JheanSilva/img-vent/AFS/STG-AFS500.png

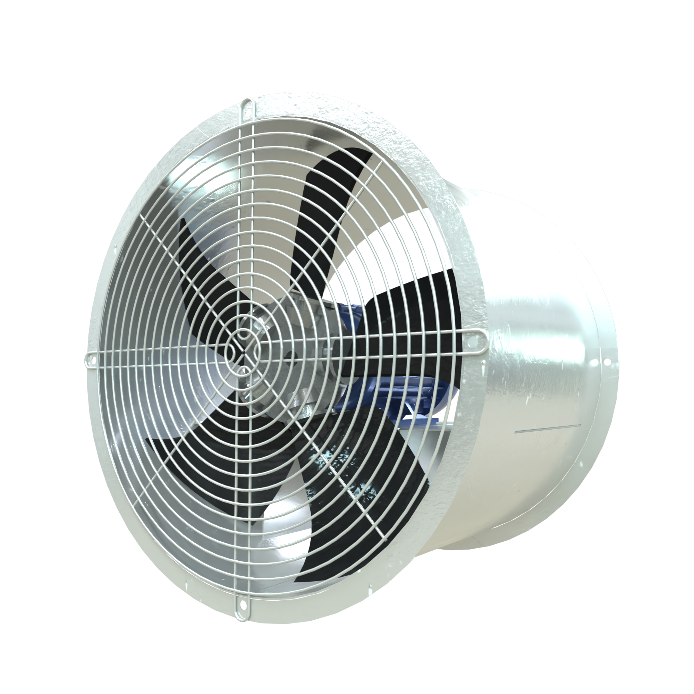
AFS/STG-AFS500.png
