JheanSilva/img-vent/AFS/STG-AFS800.png

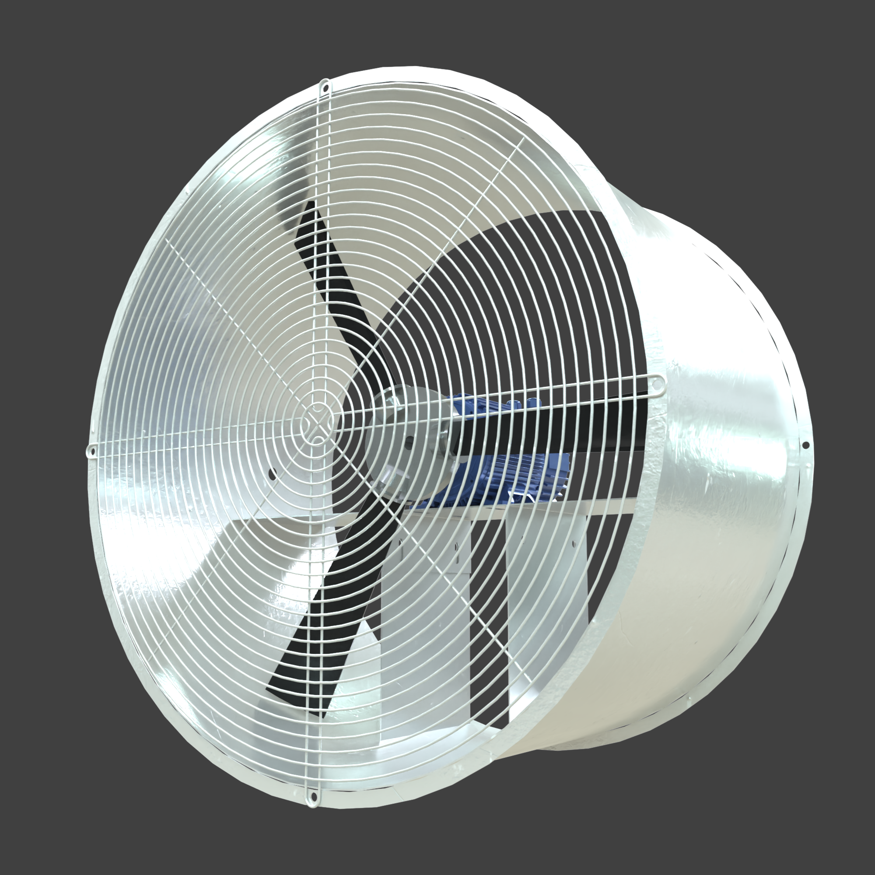
AFS/STG-AFS800.png
