JheanSilva/img-vent/AFSW/AFSW800.png

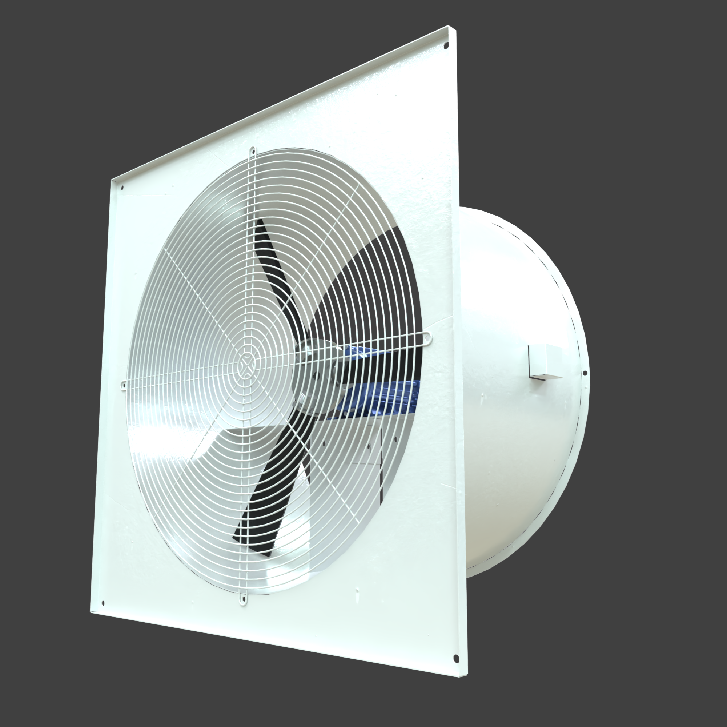
AFSW/AFSW800.png
