JheanSilva/img-vent/AFSW/STG-AFSW500.png

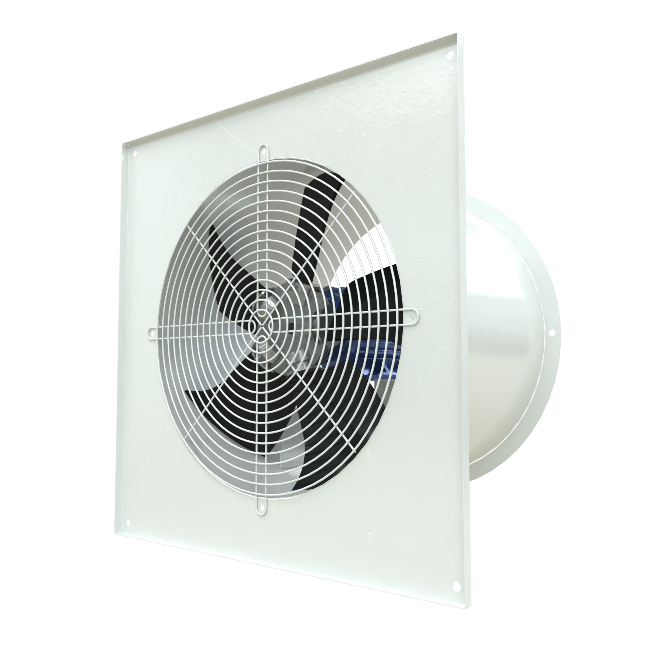
AFSW/STG-AFSW500.png
