JheanSilva/img-vent/AJF/STG-AJF.png

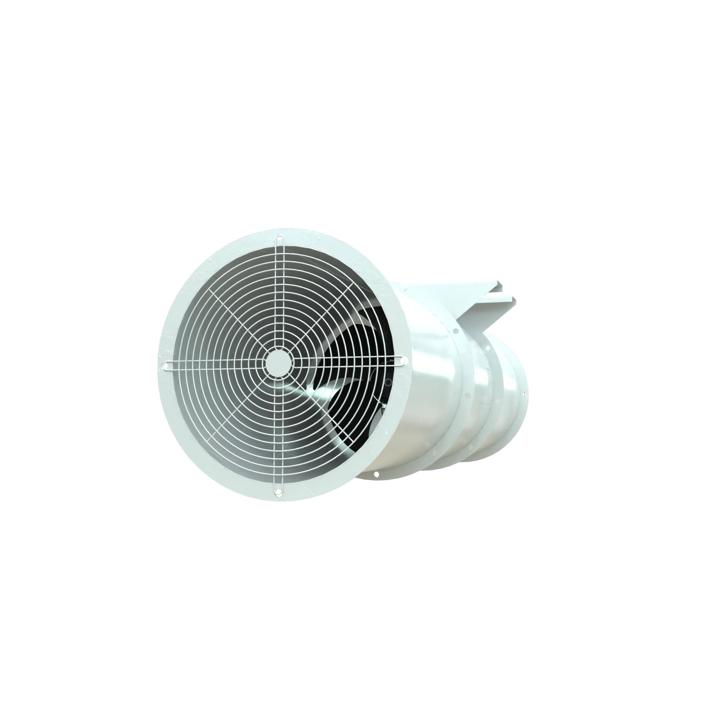
AJF/STG-AJF.png
