JheanSilva/img-vent/PF/STG-PF.png

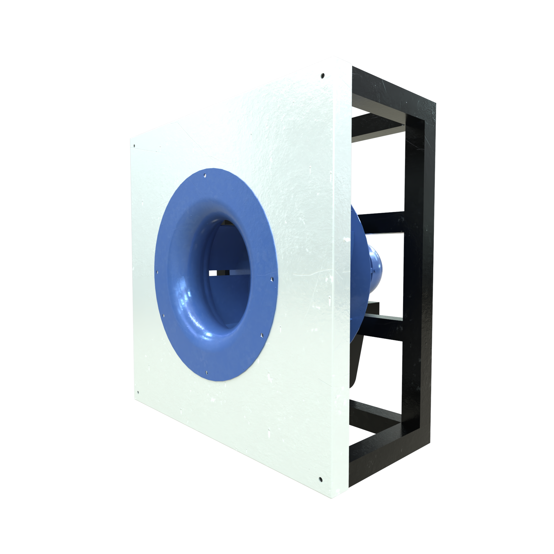
PF/STG-PF.png
