JheanSilva/img-vent/RFV/STG-RFV.png

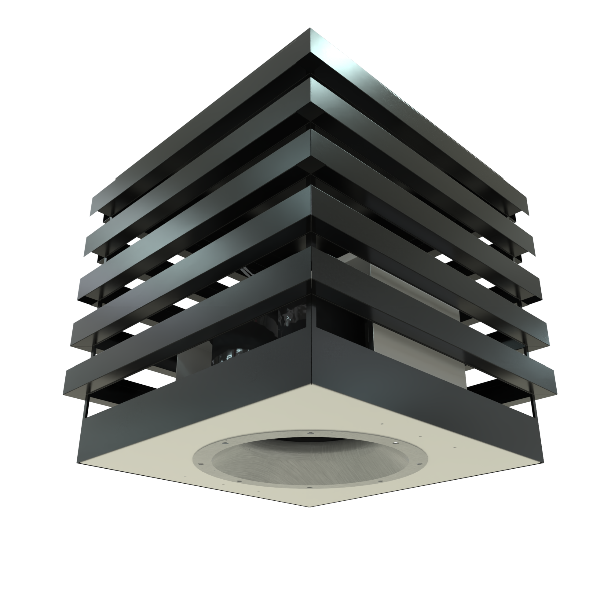
RFV/STG-RFV.png
