JheanSilva/img-vent/SJF/STG-SJF DUPLO.png

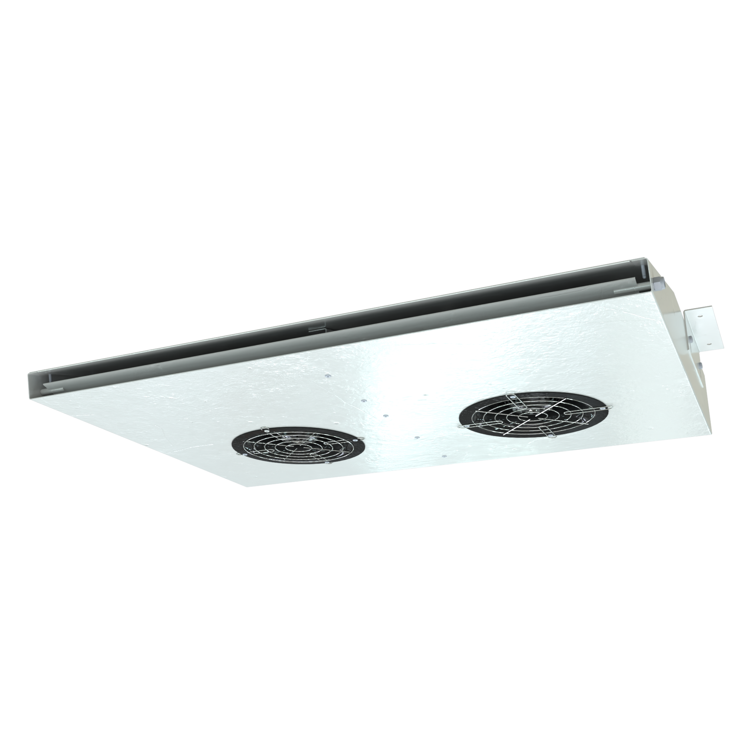
SJF/STG-SJF DUPLO.png
