JheanSilva/img-vent/SJF/STG-SJF.png

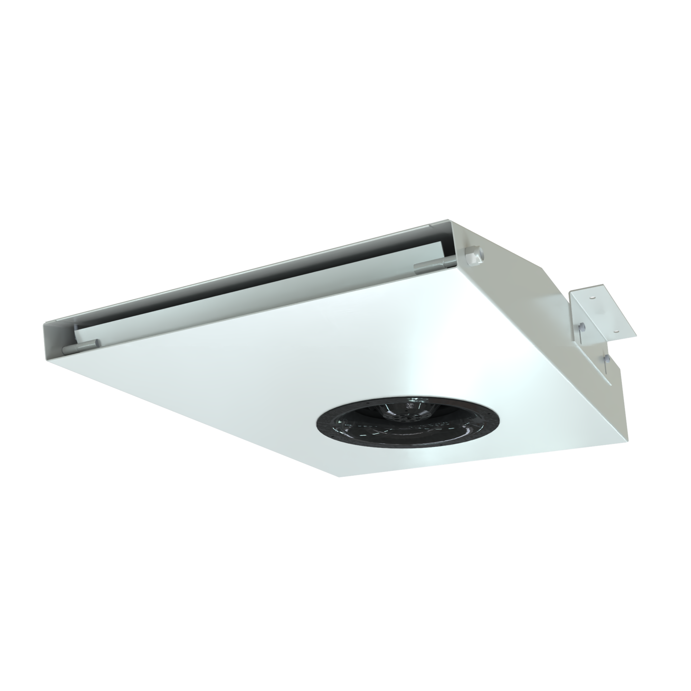
SJF/STG-SJF.png
