JheanSilva/img-vent/VB/STG-VB200.png

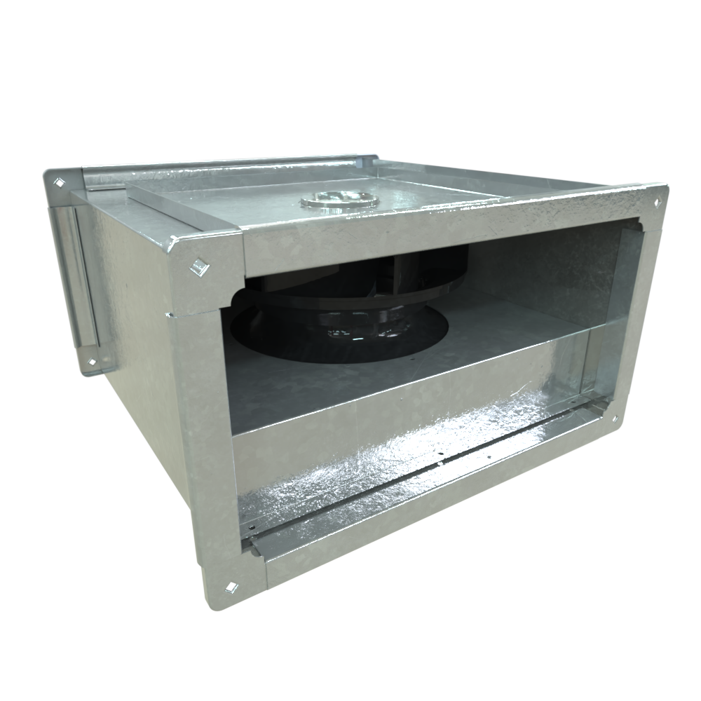
VB/STG-VB200.png
