JheanSilva/img-vent/VB/STG-VB 2.png

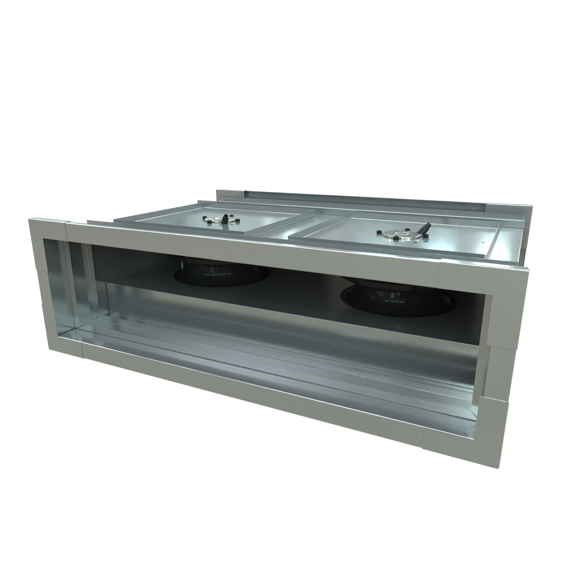
VB/STG-VB 2.png
