JheanSilva/img-vent/VB/STG-VB 4.png

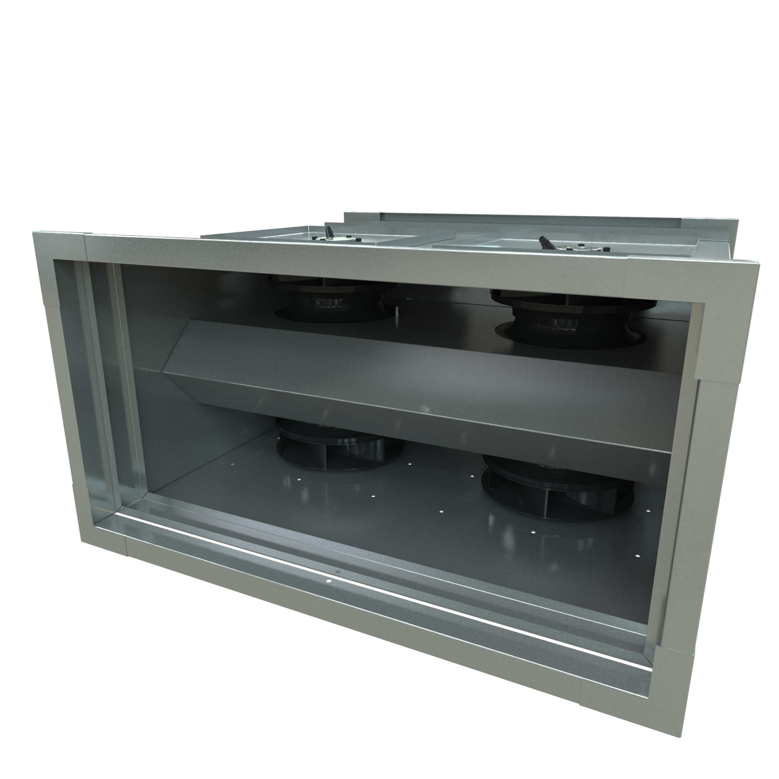
VB/STG-VB 4.png
