JheanSilva/img-vent/VB/STG-VB.png

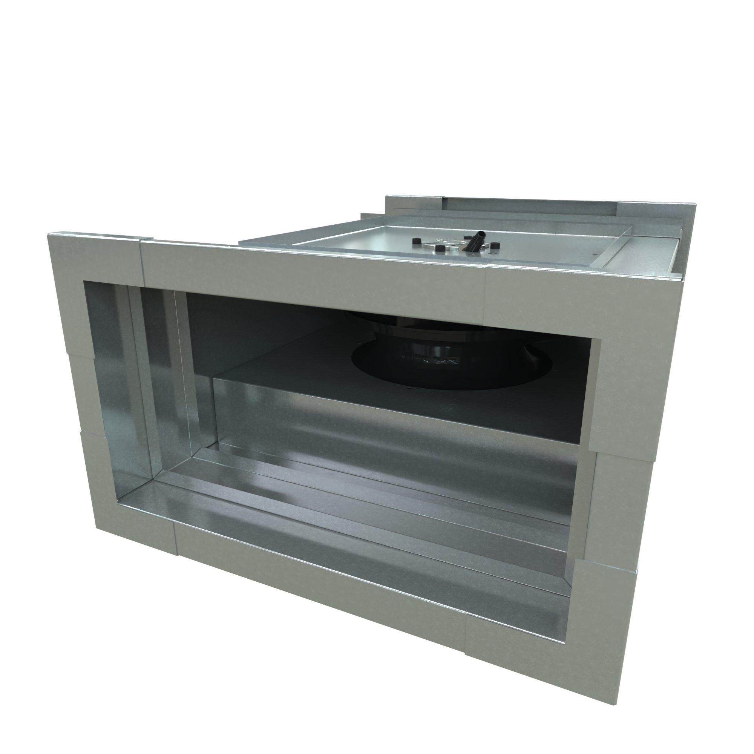
VB/STG-VB.png
