JheanSilva/img-vent/VBQ/STG-VBQ 1.png

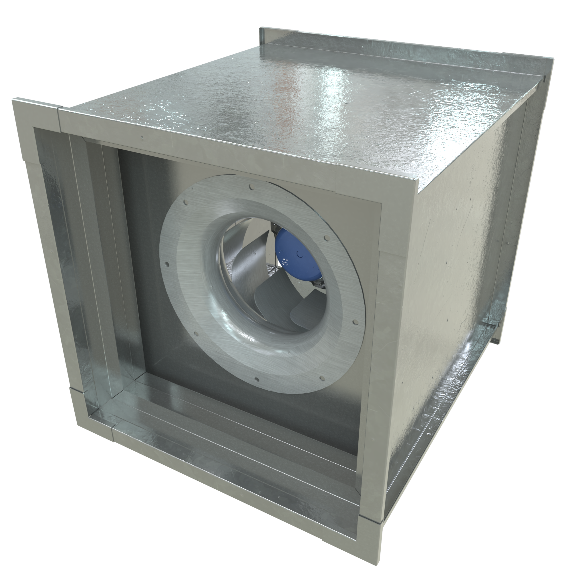
VBQ/STG-VBQ 1.png
