JheanSilva/img-vent/projeto/dxf/PEL-0301_06.dxf

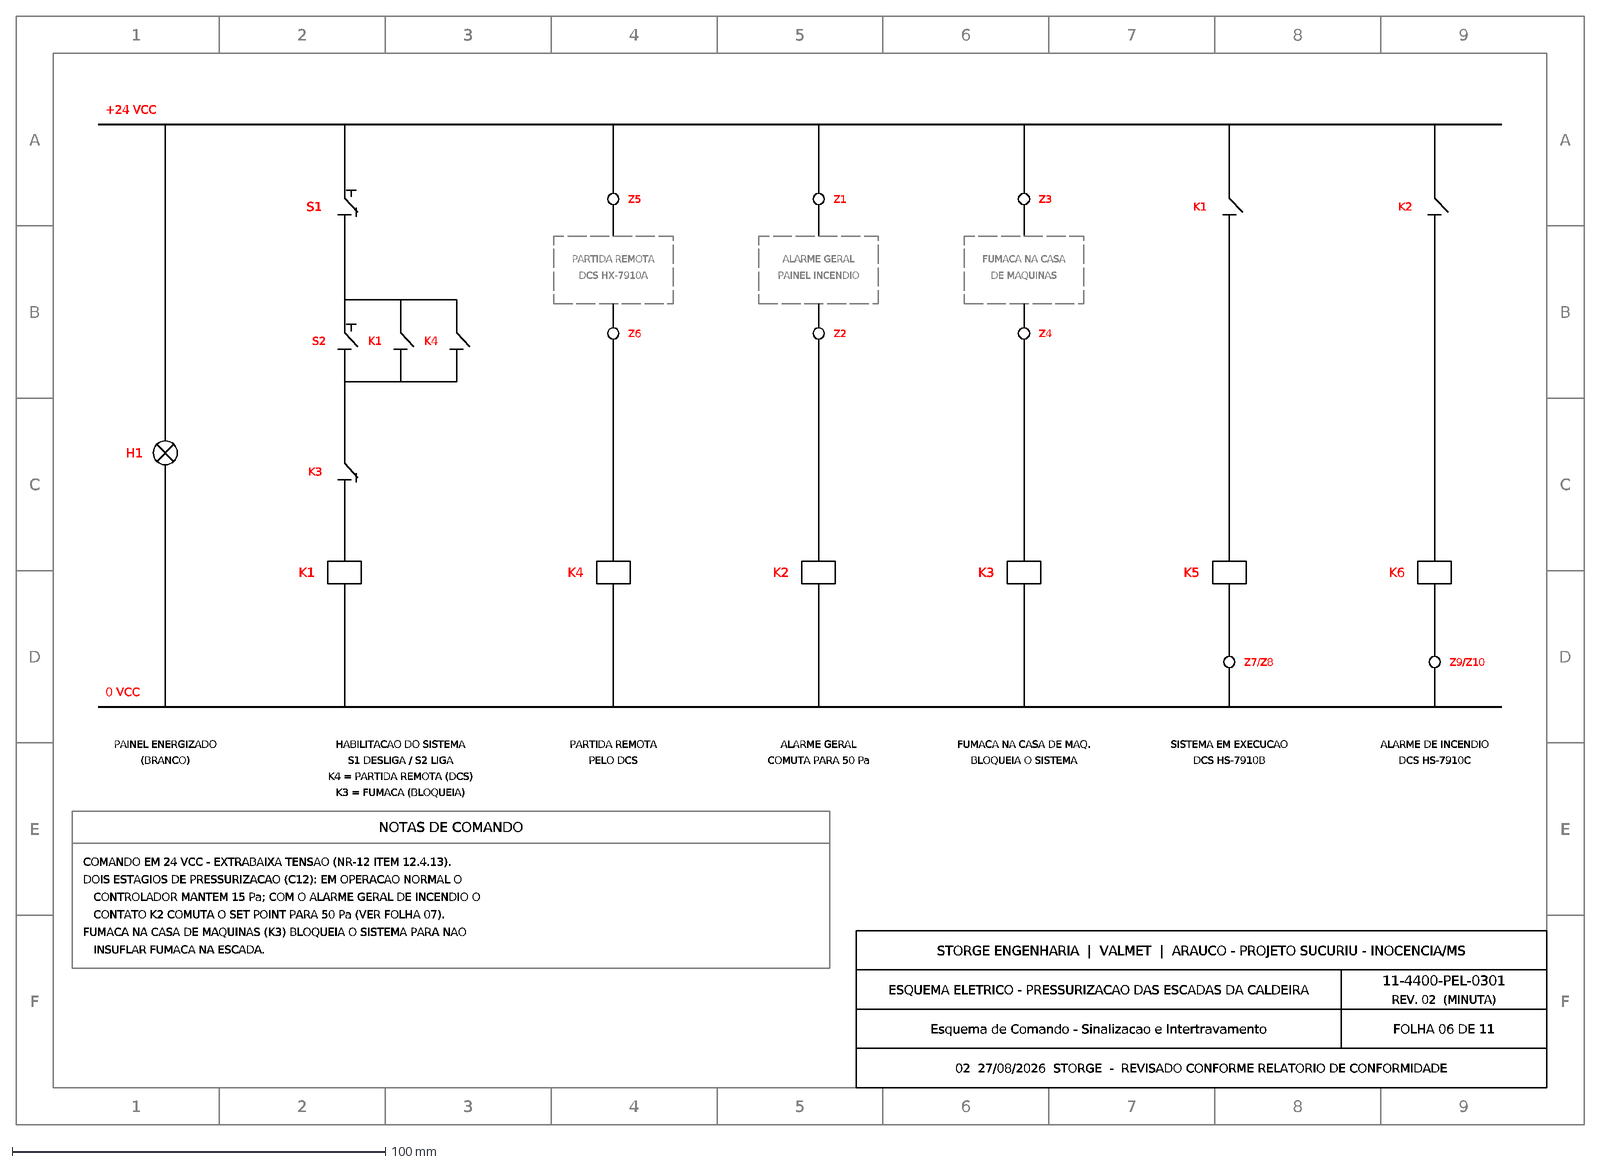
[picture p25: CAD file, 2026-08-29]
projeto/dxf/PEL-0301_06.dxf
1
2
3
4
5
6
7
8
9
F
E
D
C
B
A
STORGE ENGENHARIA | VALMET | ARAUCO - PROJETO SUCURIU - INOCENCIA/MS
ESQUEMA ELETRICO - PRESSURIZACAO DAS ESCADAS DA CALDEIRA
11-4400-PEL-0301
REV. 02 (MINUTA)
Esquema de Comando - Sinalizacao e Intertravamento
FOLHA 06 DE 11
02 27/08/2026 STORGE - REVISADO CONFORME RELATORIO DE CONFORMIDADE
+24 VCC
0 VCC
H1
PAINEL ENERGIZADO
(BRANCO)
S1
S2
K1
K4
K3
HABILITACAO DO SISTEMA
S1 DESLIGA / S2 LIGA
K4 = PARTIDA REMOTA (DCS)
K3 = FUMACA (BLOQUEIA)
PARTIDA REMOTA
DCS HX-7910A
Z5
Z6
PELO DCS
ALARME GERAL
PAINEL INCENDIO
K2
Z1
Z2
COMUTA PARA 50 Pa
FUMACA NA CASA
DE MAQUINAS
Z3
Z4
FUMACA NA CASA DE MAQ.
BLOQUEIA O SISTEMA
K5
Z7/Z8
SISTEMA EM EXECUCAO
DCS HS-7910B
K6
Z9/Z10
ALARME DE INCENDIO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
