JheanSilva/img-vent/projeto/dxf_layout/LAYOUT_L2.dxf

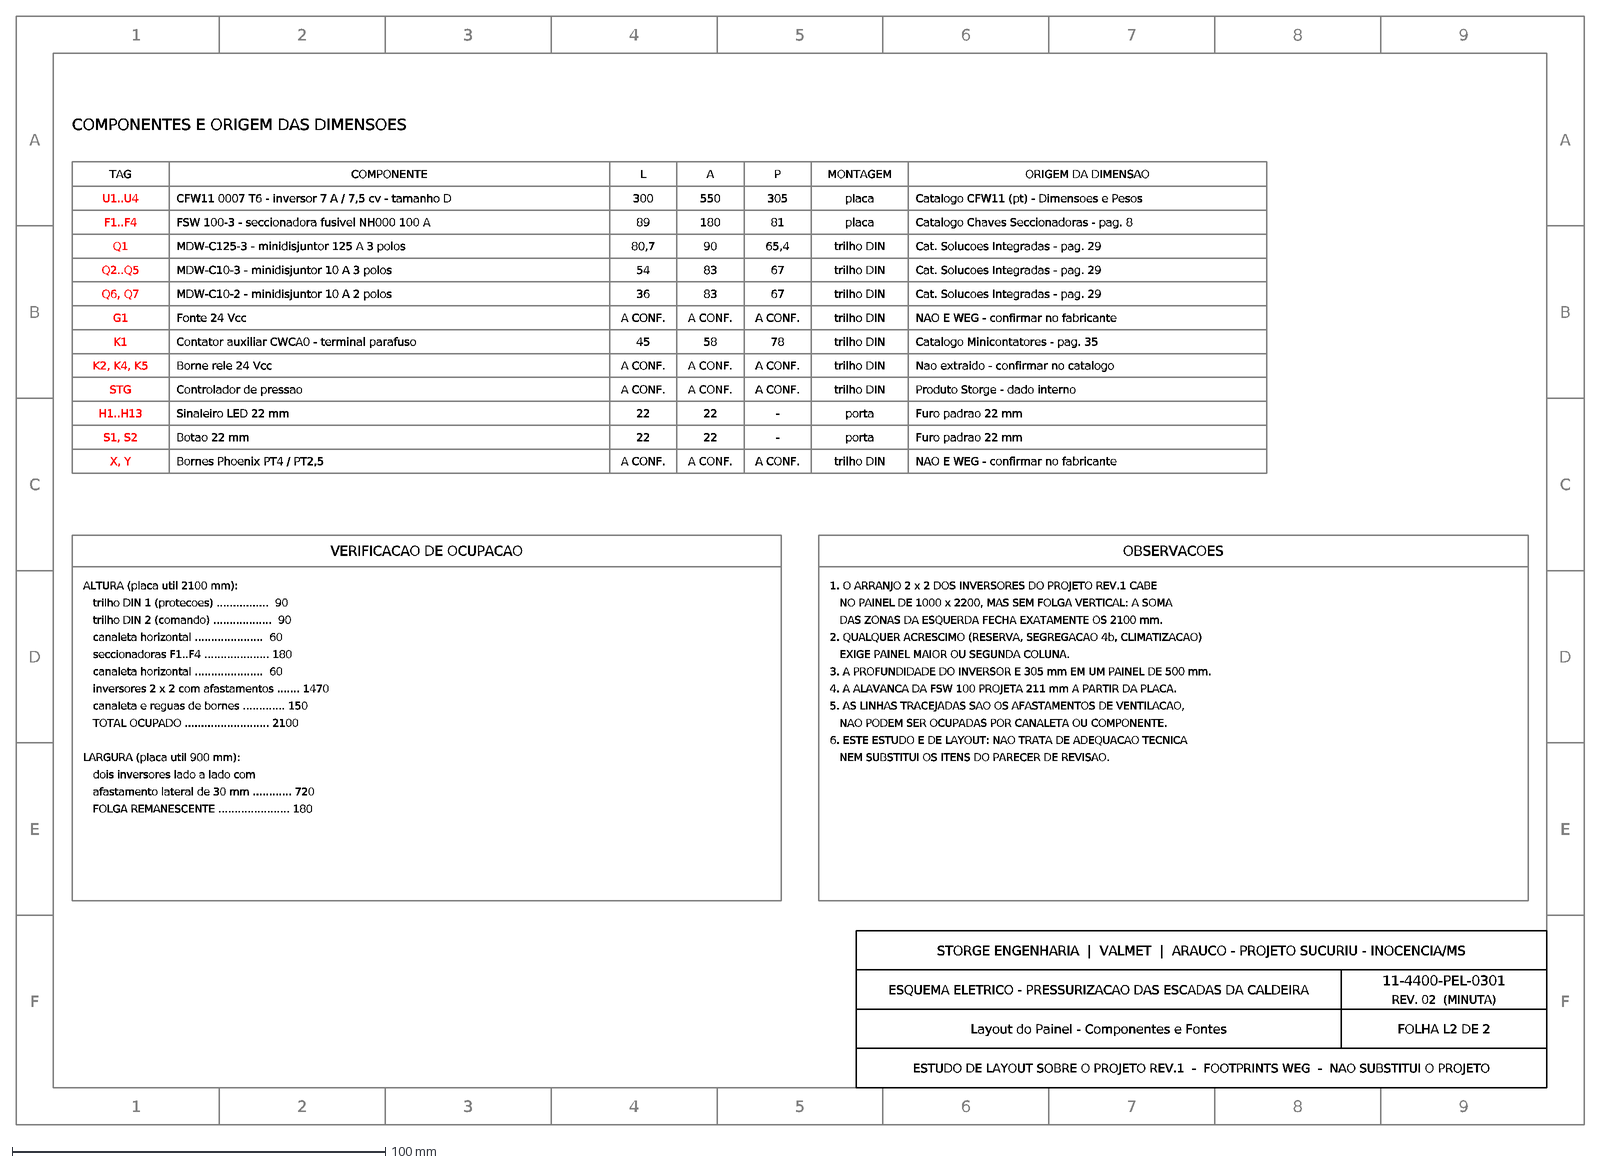
[picture p26: CAD file, 2026-09-03]
projeto/dxf_layout/LAYOUT_L2.dxf
1
2
3
4
5
6
7
8
9
F
E
D
C
B
A
STORGE ENGENHARIA | VALMET | ARAUCO - PROJETO SUCURIU - INOCENCIA/MS
ESQUEMA ELETRICO - PRESSURIZACAO DAS ESCADAS DA CALDEIRA
11-4400-PEL-0301
REV. 02 (MINUTA)
Layout do Painel - Componentes e Fontes
FOLHA L2 DE 2
ESTUDO DE LAYOUT SOBRE O PROJETO REV.1 - FOOTPRINTS WEG - NAO SUBSTITUI O PROJETO
COMPONENTES E ORIGEM DAS DIMENSOES
TAG
COMPONENTE
L
P
MONTAGEM
ORIGEM DA DIMENSAO
U1..U4
CFW11 0007 T6 - inversor 7 A / 7,5 cv - tamanho D
300
550
305
placa
Catalogo CFW11 (pt) - Dimensoes e Pesos
F1..F4
FSW 100-3 - seccionadora fusivel NH000 100 A
89
180
81
Catalogo Chaves Seccionadoras - pag. 8
Q1
MDW-C125-3 - minidisjuntor 125 A 3 polos
80,7
90
65,4
trilho DIN
Cat. Solucoes Integradas - pag. 29
Q2..Q5
MDW-C10-3 - minidisjuntor 10 A 3 polos
54
83
67
Q6, Q7
MDW-C10-2 - minidisjuntor 10 A 2 polos
36
G1
Fonte 24 Vcc
A CONF.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
