JheanSilva/img-vent/projeto/PEL-0301_unifilar_piloto.dxf

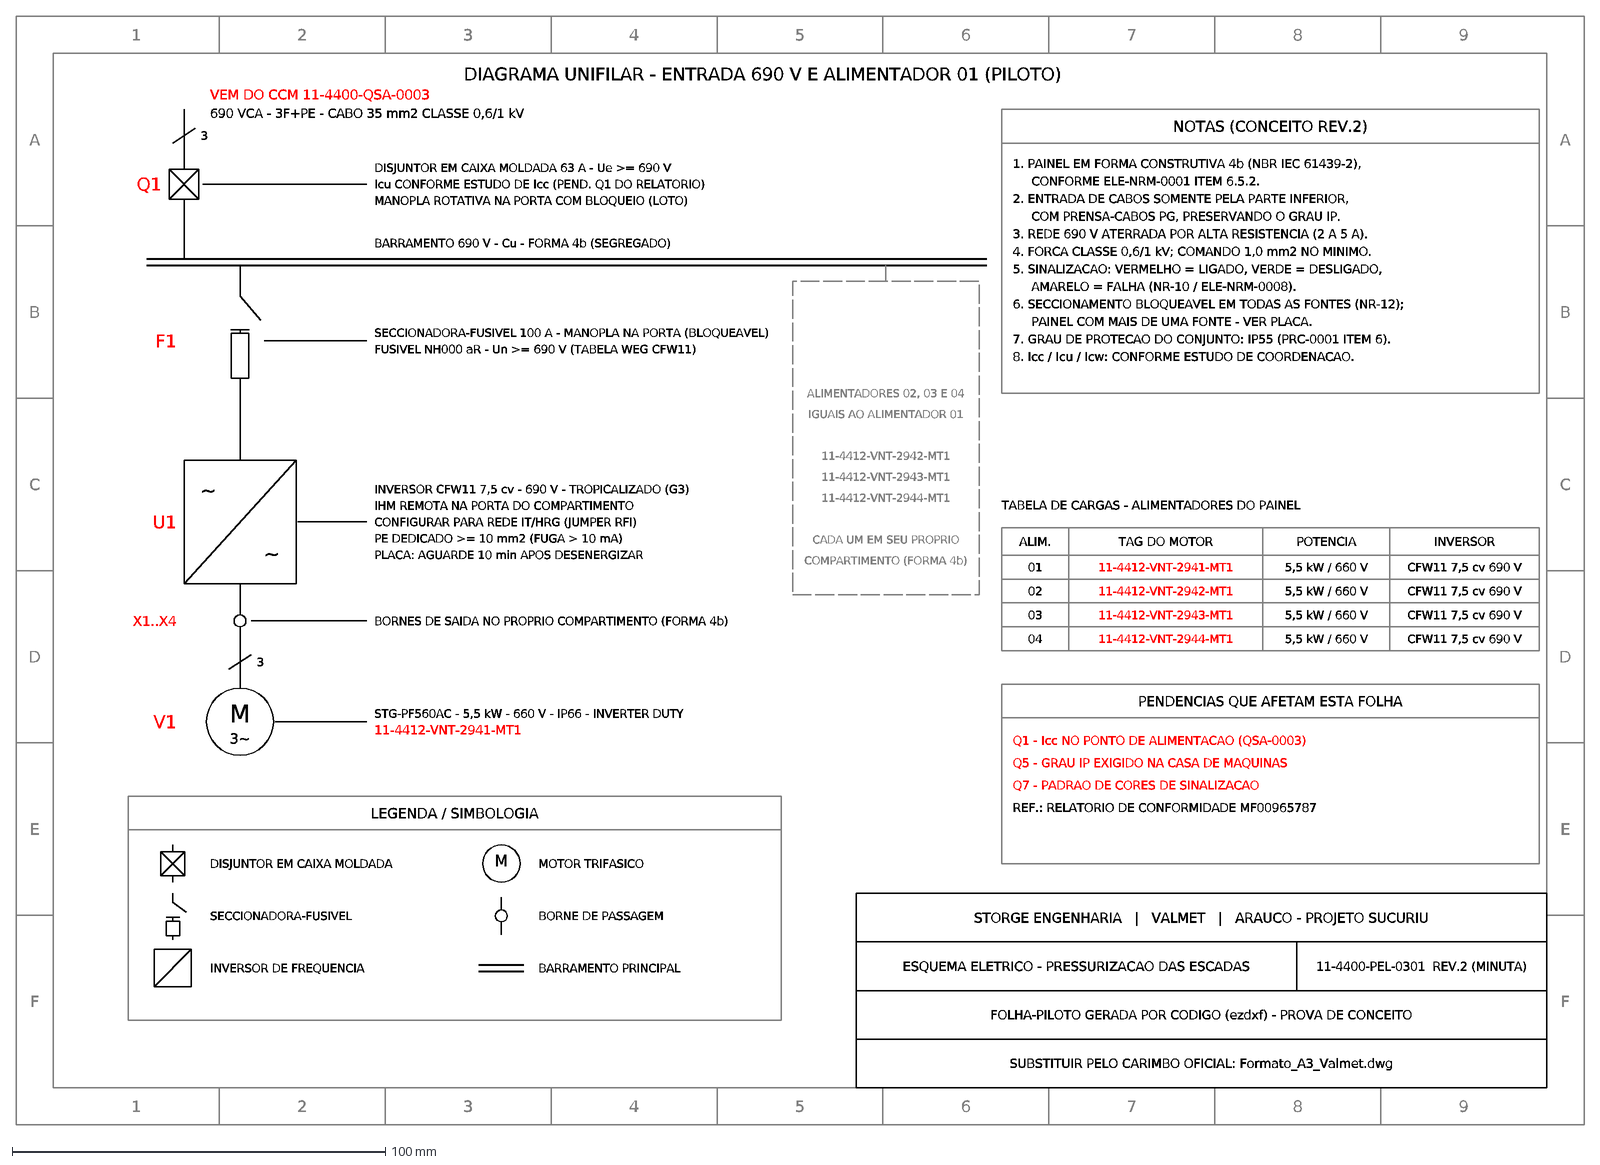
[picture p27: CAD file, 2026-08-28]
projeto/PEL-0301_unifilar_piloto.dxf
1
2
3
4
5
6
7
8
9
F
E
D
C
B
A
DIAGRAMA UNIFILAR - ENTRADA 690 V E ALIMENTADOR 01 (PILOTO)
VEM DO CCM 11-4400-QSA-0003
690 VCA - 3F+PE - CABO 35 mm2 CLASSE 0,6/1 kV
Q1
DISJUNTOR EM CAIXA MOLDADA 63 A - Ue >= 690 V
Icu CONFORME ESTUDO DE Icc (PEND. Q1 DO RELATORIO)
MANOPLA ROTATIVA NA PORTA COM BLOQUEIO (LOTO)
BARRAMENTO 690 V - Cu - FORMA 4b (SEGREGADO)
F1
SECCIONADORA-FUSIVEL 100 A - MANOPLA NA PORTA (BLOQUEAVEL)
FUSIVEL NH000 aR - Un >= 690 V (TABELA WEG CFW11)
~
U1
INVERSOR CFW11 7,5 cv - 690 V - TROPICALIZADO (G3)
IHM REMOTA NA PORTA DO COMPARTIMENTO
CONFIGURAR PARA REDE IT/HRG (JUMPER RFI)
PE DEDICADO >= 10 mm2 (FUGA > 10 mA)
PLACA: AGUARDE 10 min APOS DESENERGIZAR
X1..X4
BORNES DE SAIDA NO PROPRIO COMPARTIMENTO (FORMA 4b)
M
3~
V1
STG-PF560AC - 5,5 kW - 660 V - IP66 - INVERTER DUTY
11-4412-VNT-2941-MT1
ALIMENTADORES 02, 03 E 04
IGUAIS AO ALIMENTADOR 01
11-4412-VNT-2942-MT1
11-4412-VNT-2943-MT1
11-4412-VNT-2944-MT1
CADA UM EM SEU PROPRIO
COMPARTIMENTO (FORMA 4b)
LEGENDA / SIMBOLOGIA
DISJUNTOR EM CAIXA MOLDADA
SECCIONADORA-FUSIVEL
INVERSOR DE FREQUENCIA
MOTOR TRIFASICO
BORNE DE PASSAGEM
BARRAMENTO PRINCIPAL
NOTAS (CONCEITO REV.2)
1. PAINEL EM FORMA CONSTRUTIVA 4b (NBR IEC 61439-2),
CONFORME ELE-NRM-0001 ITEM 6.5.2.
2. ENTRADA DE CABOS SOMENTE PELA PARTE INFERIOR,
COM PRENSA-CABOS PG, PRESERVANDO O GRAU IP.
3. REDE 690 V ATERRADA POR ALTA RESISTENCIA (2 A 5 A).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
