JheanSilva/img-vent/projeto/dxf/PEL-0301_02.dxf

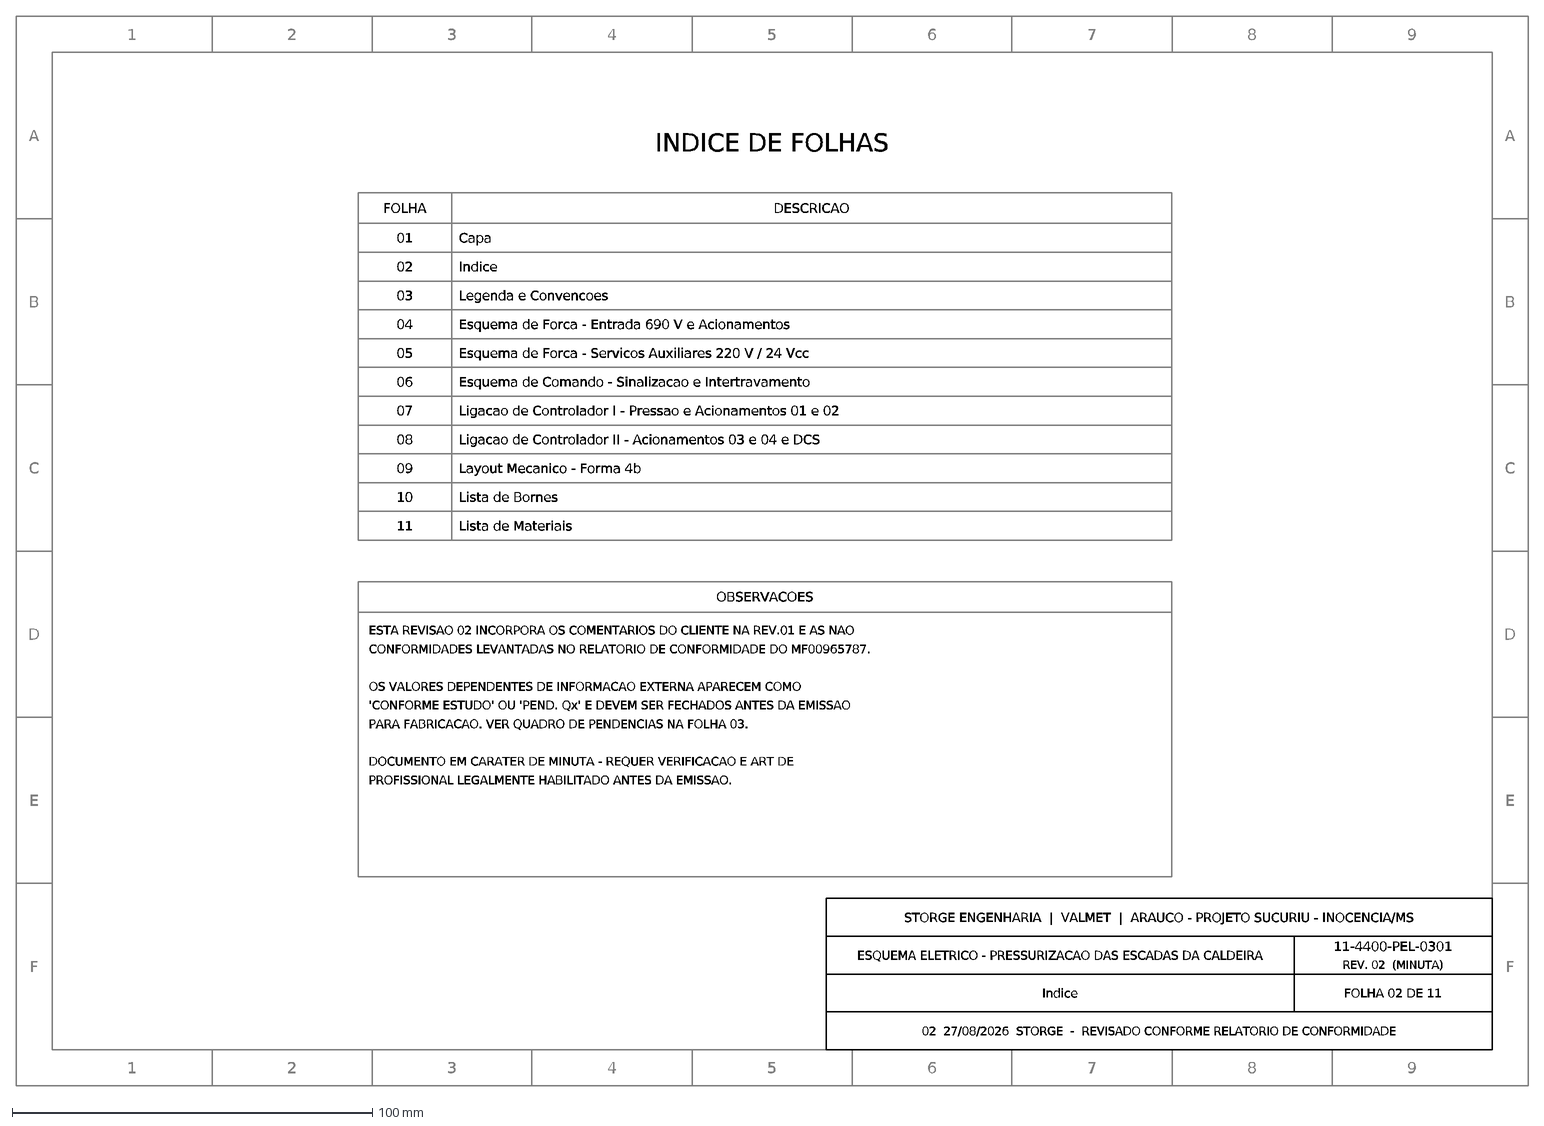
[picture p28: CAD file, 2026-08-29]
projeto/dxf/PEL-0301_02.dxf
1
2
3
4
5
6
7
8
9
F
E
D
C
B
A
STORGE ENGENHARIA | VALMET | ARAUCO - PROJETO SUCURIU - INOCENCIA/MS
ESQUEMA ELETRICO - PRESSURIZACAO DAS ESCADAS DA CALDEIRA
11-4400-PEL-0301
REV. 02 (MINUTA)
Indice
FOLHA 02 DE 11
02 27/08/2026 STORGE - REVISADO CONFORME RELATORIO DE CONFORMIDADE
INDICE DE FOLHAS
FOLHA
DESCRICAO
01
Capa
02
03
Legenda e Convencoes
04
Esquema de Forca - Entrada 690 V e Acionamentos
05
Esquema de Forca - Servicos Auxiliares 220 V / 24 Vcc
06
Esquema de Comando - Sinalizacao e Intertravamento
07
Ligacao de Controlador I - Pressao e Acionamentos 01 e 02
08
Ligacao de Controlador II - Acionamentos 03 e 04 e DCS
09
Layout Mecanico - Forma 4b
10
Lista de Bornes
11
Lista de Materiais
OBSERVACOES
ESTA REVISAO 02 INCORPORA OS COMENTARIOS DO CLIENTE NA REV.01 E AS NAO
CONFORMIDADES LEVANTADAS NO RELATORIO DE CONFORMIDADE DO MF00965787.
OS VALORES DEPENDENTES DE INFORMACAO EXTERNA APARECEM COMO
'CONFORME ESTUDO' OU 'PEND. Qx' E DEVEM SER FECHADOS ANTES DA EMISSAO
PARA FABRICACAO. VER QUADRO DE PENDENCIAS NA FOLHA 03.
DOCUMENTO EM CARATER DE MINUTA - REQUER VERIFICACAO E ART DE
PROFISSIONAL LEGALMENTE HABILITADO ANTES DA EMISSAO.
