JheanSilva/img-vent/projeto/dxf_layout/LAYOUT_L1.dxf

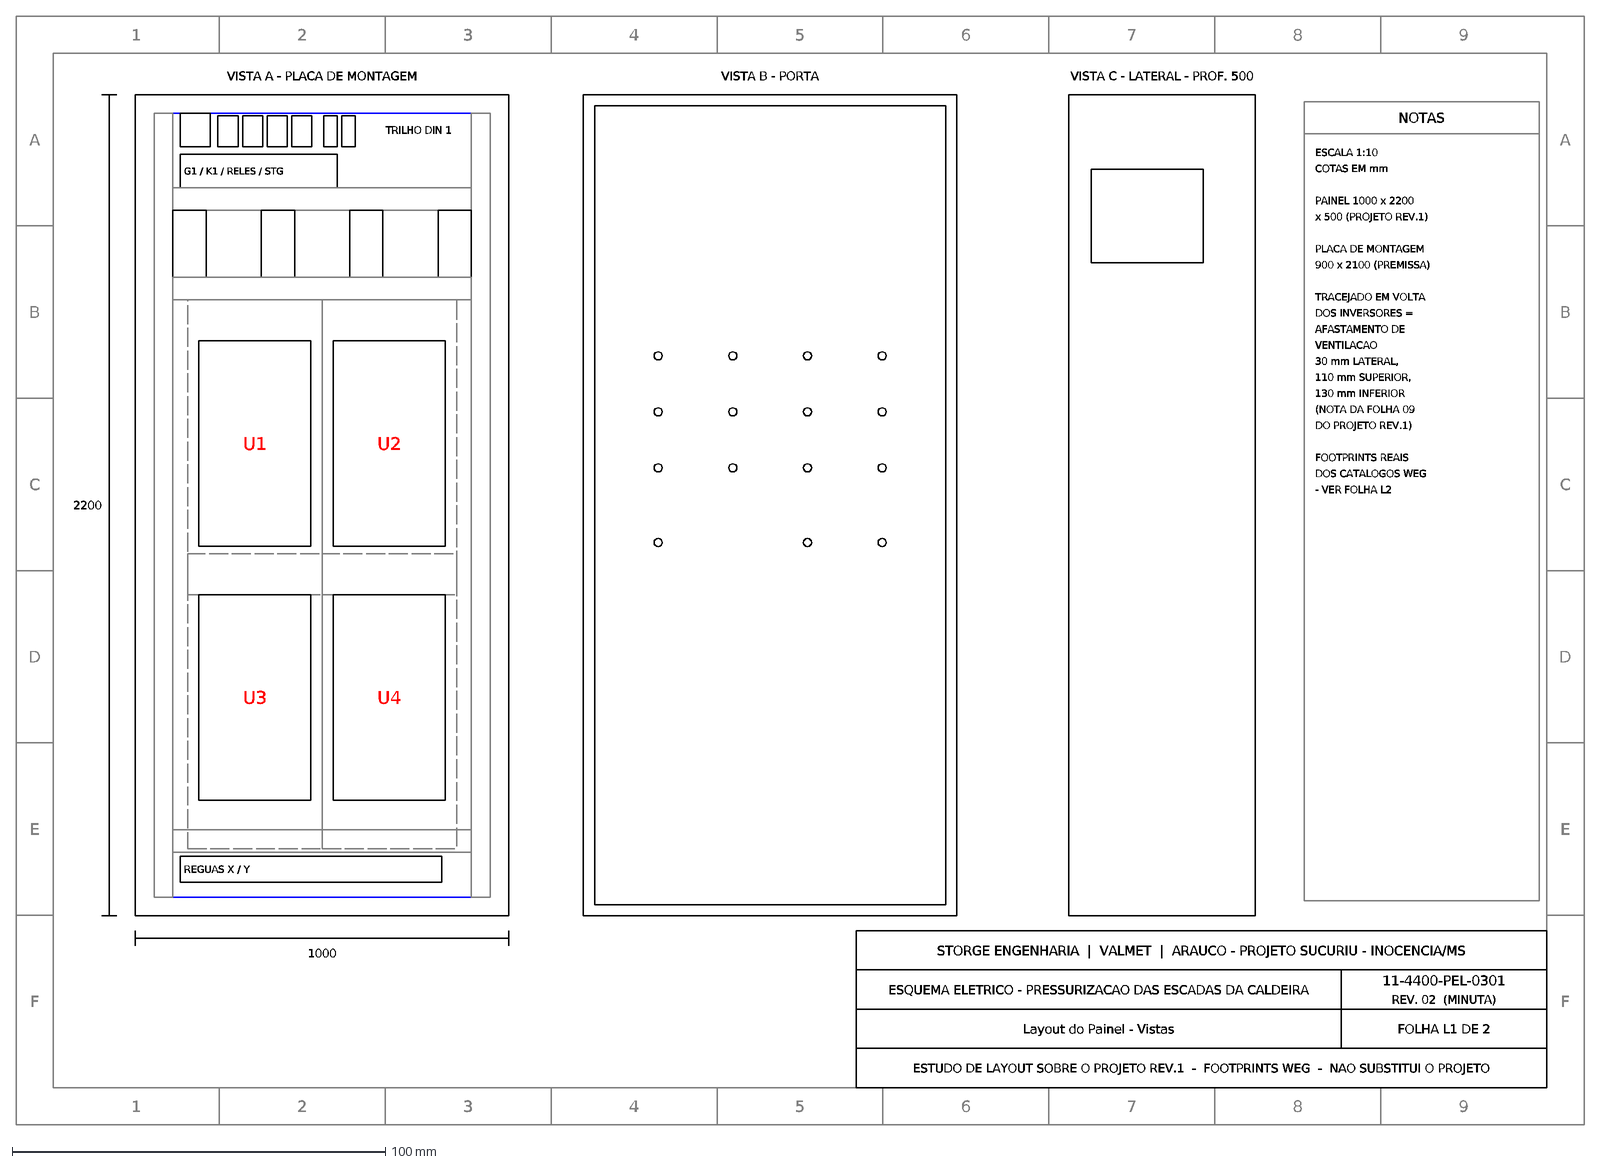
[picture p29: CAD file, 2026-09-03]
projeto/dxf_layout/LAYOUT_L1.dxf
1
2
3
4
5
6
7
8
9
F
E
D
C
B
A
STORGE ENGENHARIA | VALMET | ARAUCO - PROJETO SUCURIU - INOCENCIA/MS
ESQUEMA ELETRICO - PRESSURIZACAO DAS ESCADAS DA CALDEIRA
11-4400-PEL-0301
REV. 02 (MINUTA)
Layout do Painel - Vistas
FOLHA L1 DE 2
ESTUDO DE LAYOUT SOBRE O PROJETO REV.1 - FOOTPRINTS WEG - NAO SUBSTITUI O PROJETO
TRILHO DIN 1
G1 / K1 / RELES / STG
U1
U2
U3
U4
REGUAS X / Y
VISTA A - PLACA DE MONTAGEM
VISTA B - PORTA
VISTA C - LATERAL - PROF. 500
1000
2200
NOTAS
ESCALA 1:10
COTAS EM mm
PAINEL 1000 x 2200
x 500 (PROJETO REV.1)
PLACA DE MONTAGEM
900 x 2100 (PREMISSA)
TRACEJADO EM VOLTA
DOS INVERSORES =
AFASTAMENTO DE
VENTILACAO
30 mm LATERAL,
110 mm SUPERIOR,
130 mm INFERIOR
(NOTA DA FOLHA 09
DO PROJETO REV.1)
FOOTPRINTS REAIS
DOS CATALOGOS WEG
- VER FOLHA L2
