JheanSilva/img-vent/projeto/dxf/PEL-0301_08.dxf

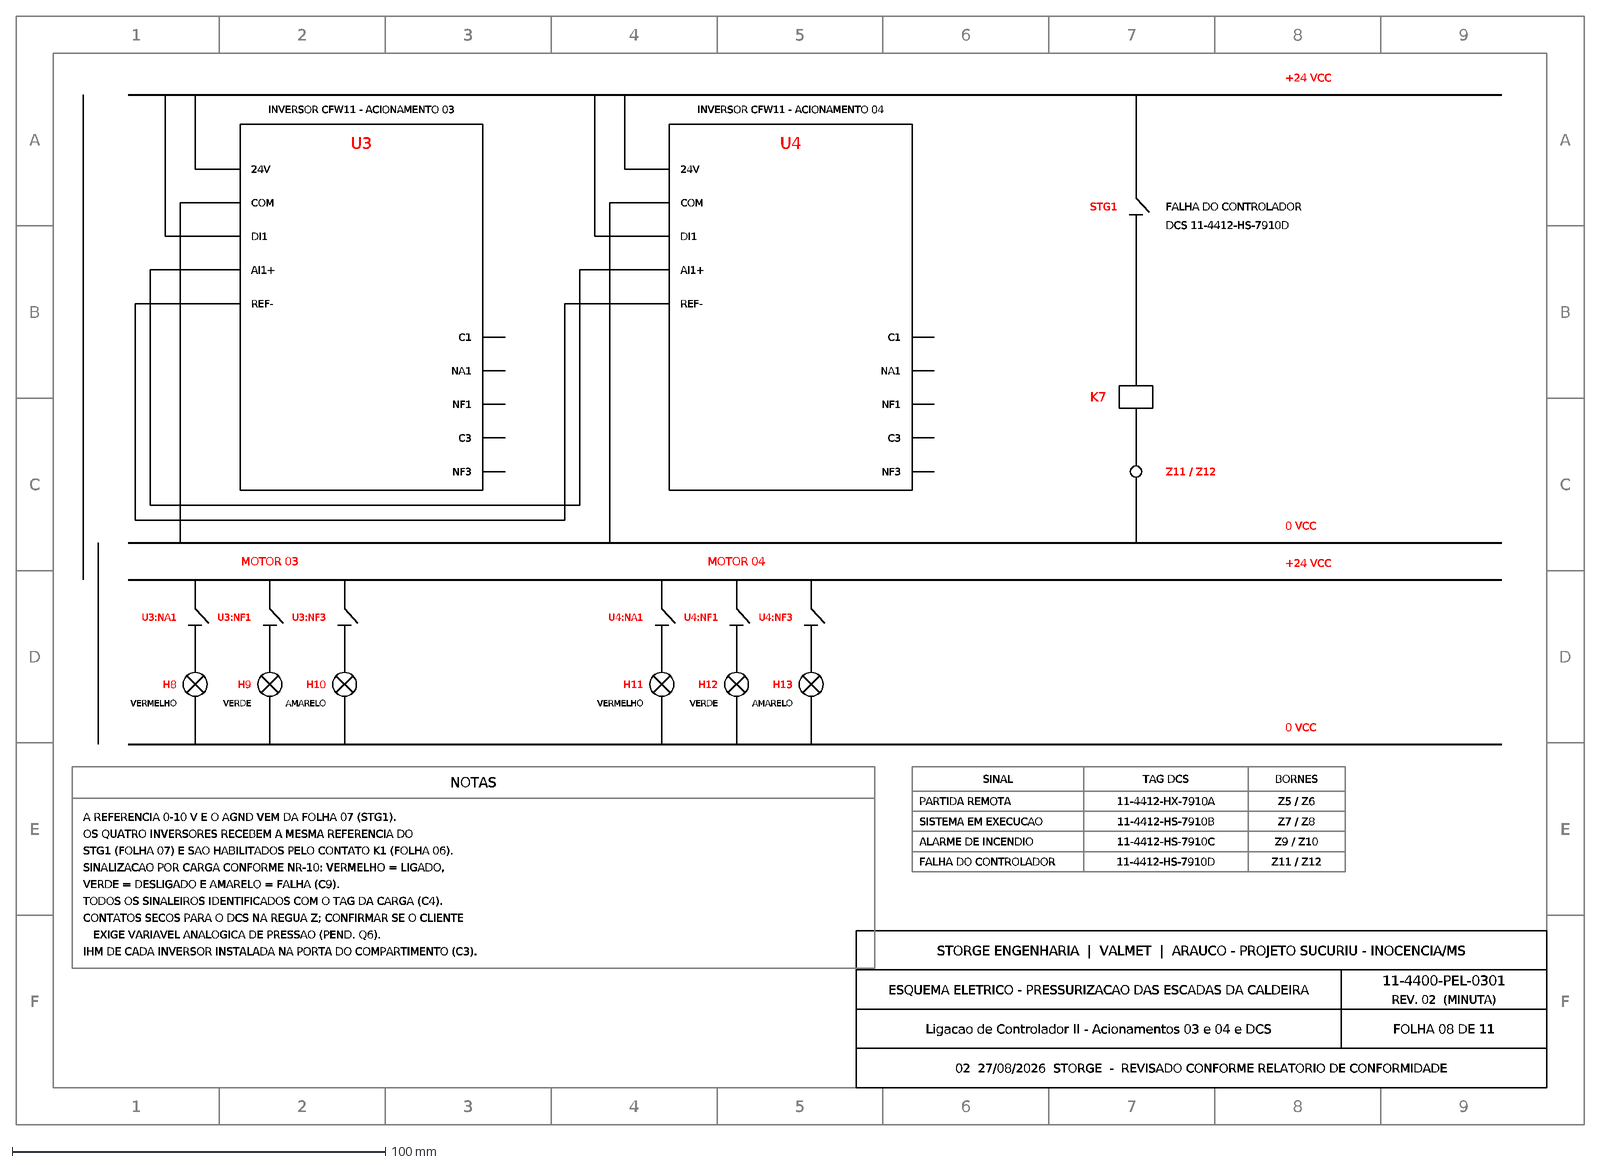
[picture p30: CAD file, 2026-08-29]
projeto/dxf/PEL-0301_08.dxf
1
2
3
4
5
6
7
8
9
F
E
D
C
B
A
STORGE ENGENHARIA | VALMET | ARAUCO - PROJETO SUCURIU - INOCENCIA/MS
ESQUEMA ELETRICO - PRESSURIZACAO DAS ESCADAS DA CALDEIRA
11-4400-PEL-0301
REV. 02 (MINUTA)
Ligacao de Controlador II - Acionamentos 03 e 04 e DCS
FOLHA 08 DE 11
02 27/08/2026 STORGE - REVISADO CONFORME RELATORIO DE CONFORMIDADE
+24 VCC
0 VCC
U3
INVERSOR CFW11 - ACIONAMENTO 03
24V
COM
DI1
AI1+
REF-
C1
NA1
NF1
C3
NF3
U4
INVERSOR CFW11 - ACIONAMENTO 04
STG1
K7
Z11 / Z12
FALHA DO CONTROLADOR
DCS 11-4412-HS-7910D
MOTOR 03
U3:NA1
H8
VERMELHO
U3:NF1
H9
VERDE
U3:NF3
H10
AMARELO
MOTOR 04
U4:NA1
H11
U4:NF1
H12
U4:NF3
H13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
