JheanSilva/img-vent/projeto/dxf/PEL-0301_09.dxf

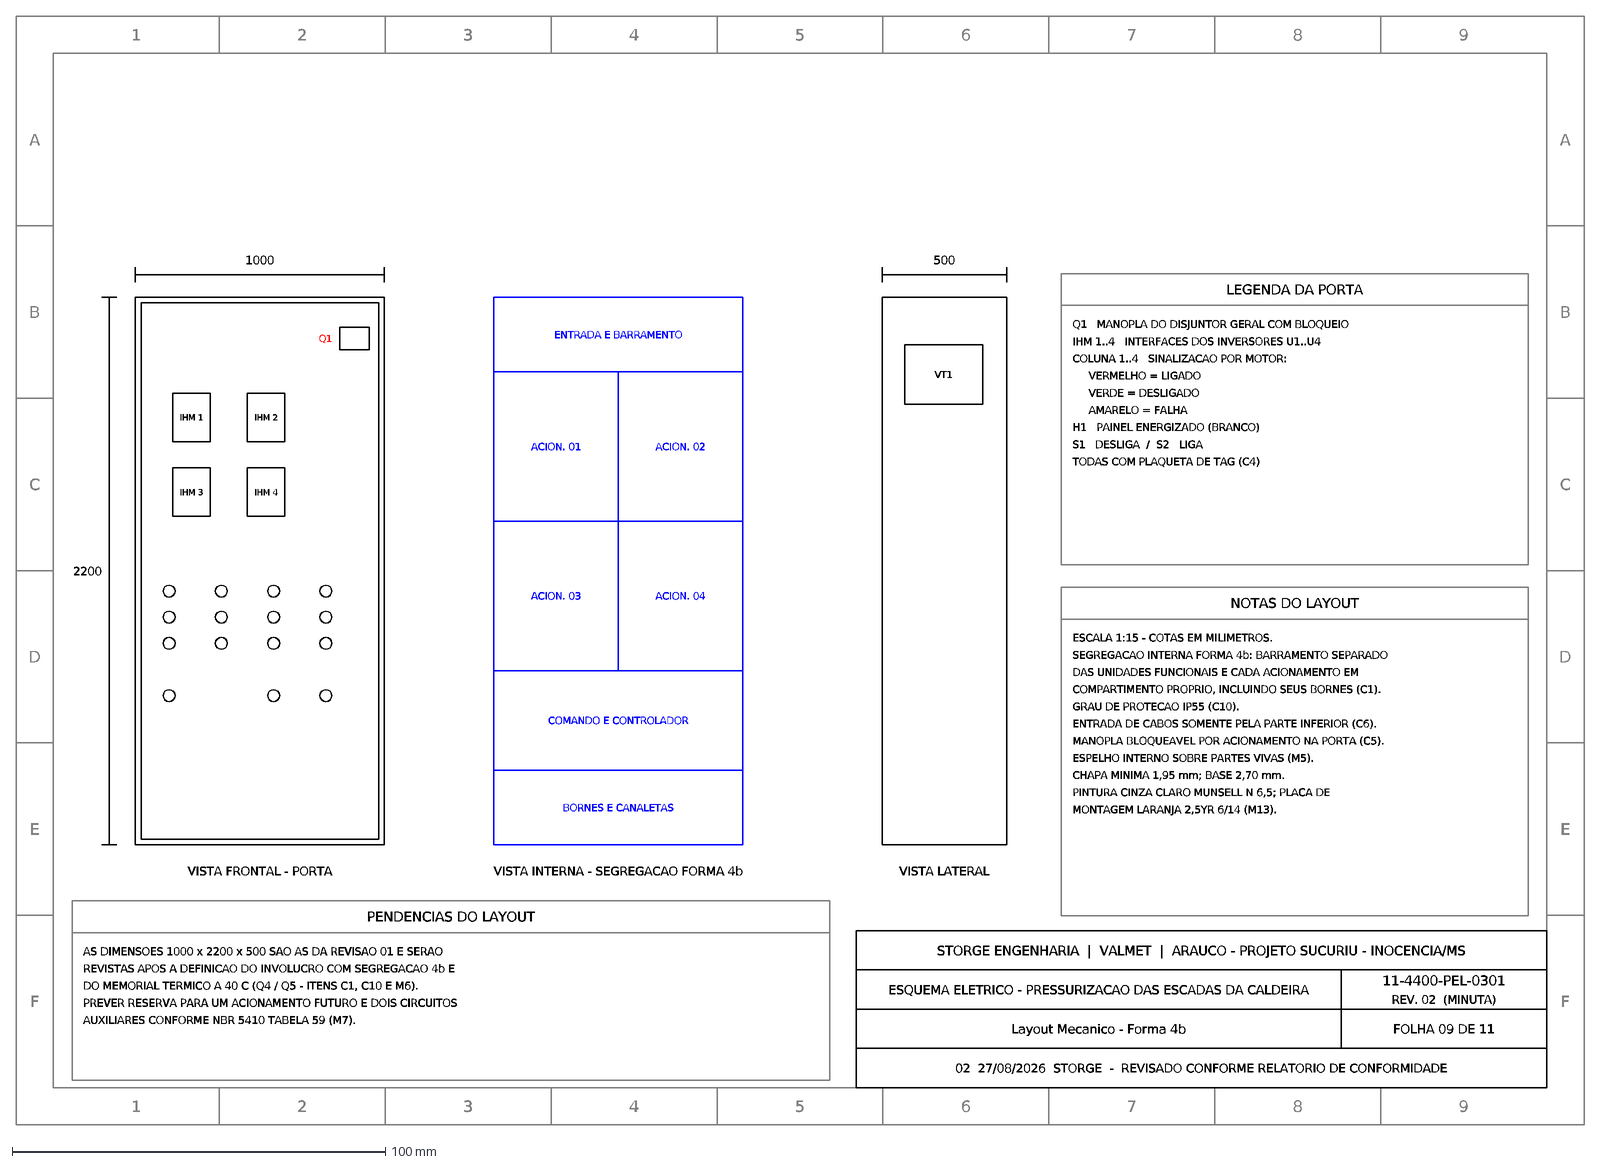
[picture p31: CAD file, 2026-08-29]
projeto/dxf/PEL-0301_09.dxf
1
2
3
4
5
6
7
8
9
F
E
D
C
B
A
STORGE ENGENHARIA | VALMET | ARAUCO - PROJETO SUCURIU - INOCENCIA/MS
ESQUEMA ELETRICO - PRESSURIZACAO DAS ESCADAS DA CALDEIRA
11-4400-PEL-0301
REV. 02 (MINUTA)
Layout Mecanico - Forma 4b
FOLHA 09 DE 11
02 27/08/2026 STORGE - REVISADO CONFORME RELATORIO DE CONFORMIDADE
1000
2200
Q1
IHM 1
IHM 2
IHM 3
IHM 4
VISTA FRONTAL - PORTA
ENTRADA E BARRAMENTO
ACION. 01
ACION. 02
ACION. 03
ACION. 04
COMANDO E CONTROLADOR
BORNES E CANALETAS
VISTA INTERNA - SEGREGACAO FORMA 4b
VT1
500
VISTA LATERAL
LEGENDA DA PORTA
Q1 MANOPLA DO DISJUNTOR GERAL COM BLOQUEIO
IHM 1..4 INTERFACES DOS INVERSORES U1..U4
COLUNA 1..4 SINALIZACAO POR MOTOR:
VERMELHO = LIGADO
VERDE = DESLIGADO
AMARELO = FALHA
H1 PAINEL ENERGIZADO (BRANCO)
S1 DESLIGA / S2 LIGA
TODAS COM PLAQUETA DE TAG (C4)
NOTAS DO LAYOUT
ESCALA 1:15 - COTAS EM MILIMETROS.
SEGREGACAO INTERNA FORMA 4b: BARRAMENTO SEPARADO
DAS UNIDADES FUNCIONAIS E CADA ACIONAMENTO EM
COMPARTIMENTO PROPRIO, INCLUINDO SEUS BORNES (C1).
GRAU DE PROTECAO IP55 (C10).
ENTRADA DE CABOS SOMENTE PELA PARTE INFERIOR (C6).
MANOPLA BLOQUEAVEL POR ACIONAMENTO NA PORTA (C5).
ESPELHO INTERNO SOBRE PARTES VIVAS (M5).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
