JheanSilva/img-vent/projeto/dxf/PEL-0301_05.dxf

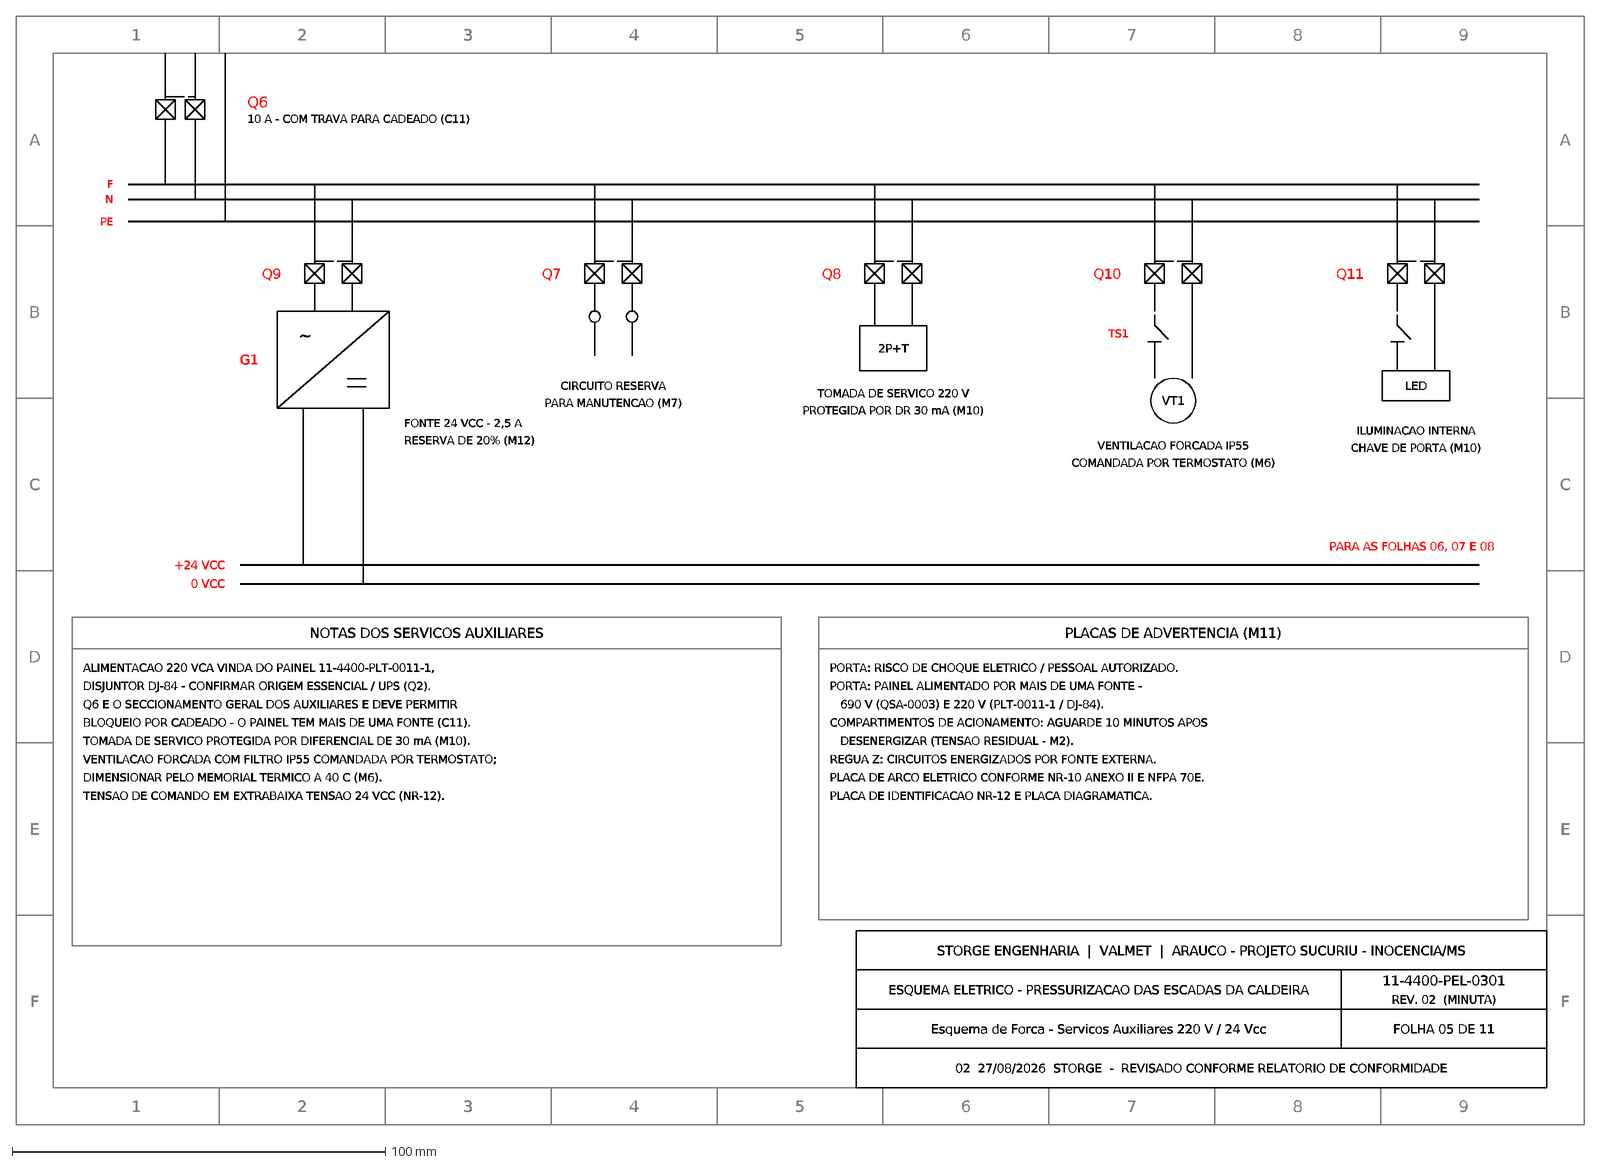
[picture p32: CAD file, 2026-08-29]
projeto/dxf/PEL-0301_05.dxf
1
2
3
4
5
6
7
8
9
F
E
D
C
B
A
STORGE ENGENHARIA | VALMET | ARAUCO - PROJETO SUCURIU - INOCENCIA/MS
ESQUEMA ELETRICO - PRESSURIZACAO DAS ESCADAS DA CALDEIRA
11-4400-PEL-0301
REV. 02 (MINUTA)
Esquema de Forca - Servicos Auxiliares 220 V / 24 Vcc
FOLHA 05 DE 11
02 27/08/2026 STORGE - REVISADO CONFORME RELATORIO DE CONFORMIDADE
Q6
10 A - COM TRAVA PARA CADEADO (C11)
N
PE
Q9
~
G1
FONTE 24 VCC - 2,5 A
RESERVA DE 20% (M12)
Q7
CIRCUITO RESERVA
PARA MANUTENCAO (M7)
Q8
2P+T
TOMADA DE SERVICO 220 V
PROTEGIDA POR DR 30 mA (M10)
Q10
TS1
VT1
VENTILACAO FORCADA IP55
COMANDADA POR TERMOSTATO (M6)
Q11
LED
ILUMINACAO INTERNA
CHAVE DE PORTA (M10)
+24 VCC
0 VCC
PARA AS FOLHAS 06, 07 E 08
NOTAS DOS SERVICOS AUXILIARES
ALIMENTACAO 220 VCA VINDA DO PAINEL 11-4400-PLT-0011-1,
DISJUNTOR DJ-84 - CONFIRMAR ORIGEM ESSENCIAL / UPS (Q2).
Q6 E O SECCIONAMENTO GERAL DOS AUXILIARES E DEVE PERMITIR
BLOQUEIO POR CADEADO - O PAINEL TEM MAIS DE UMA FONTE (C11).
TOMADA DE SERVICO PROTEGIDA POR DIFERENCIAL DE 30 mA (M10).
VENTILACAO FORCADA COM FILTRO IP55 COMANDADA POR TERMOSTATO;
DIMENSIONAR PELO MEMORIAL TERMICO A 40 C (M6).
TENSAO DE COMANDO EM EXTRABAIXA TENSAO 24 VCC (NR-12).
PLACAS DE ADVERTENCIA (M11)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
