JheanSilva/img-vent/projeto/dxf/PEL-0301_03.dxf

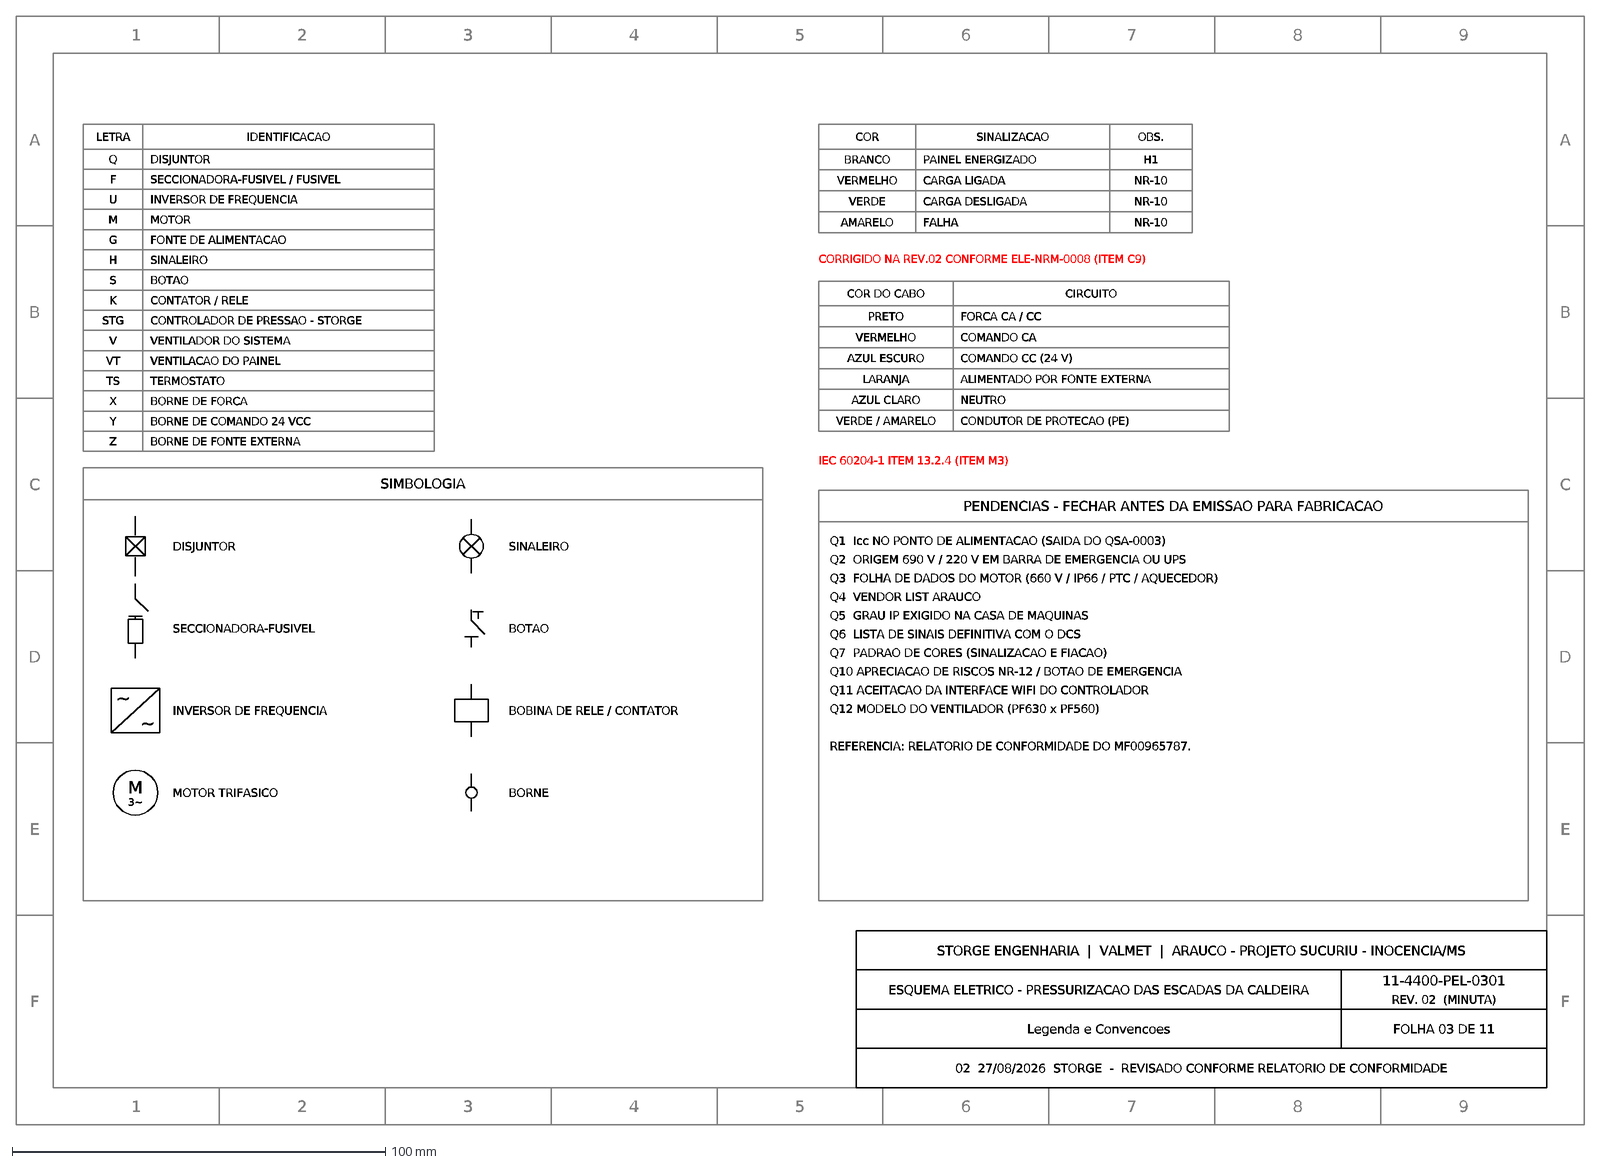
[picture p33: CAD file, 2026-08-29]
projeto/dxf/PEL-0301_03.dxf
1
2
3
4
5
6
7
8
9
F
E
D
C
B
A
STORGE ENGENHARIA | VALMET | ARAUCO - PROJETO SUCURIU - INOCENCIA/MS
ESQUEMA ELETRICO - PRESSURIZACAO DAS ESCADAS DA CALDEIRA
11-4400-PEL-0301
REV. 02 (MINUTA)
Legenda e Convencoes
FOLHA 03 DE 11
02 27/08/2026 STORGE - REVISADO CONFORME RELATORIO DE CONFORMIDADE
LETRA
IDENTIFICACAO
Q
DISJUNTOR
SECCIONADORA-FUSIVEL / FUSIVEL
U
INVERSOR DE FREQUENCIA
M
MOTOR
G
FONTE DE ALIMENTACAO
H
SINALEIRO
S
BOTAO
K
CONTATOR / RELE
STG
CONTROLADOR DE PRESSAO - STORGE
V
VENTILADOR DO SISTEMA
VT
VENTILACAO DO PAINEL
TS
TERMOSTATO
X
BORNE DE FORCA
Y
BORNE DE COMANDO 24 VCC
Z
BORNE DE FONTE EXTERNA
COR
SINALIZACAO
OBS.
BRANCO
PAINEL ENERGIZADO
H1
VERMELHO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
