JheanSilva/img-vent/projeto/dxf/PEL-0301_01.dxf

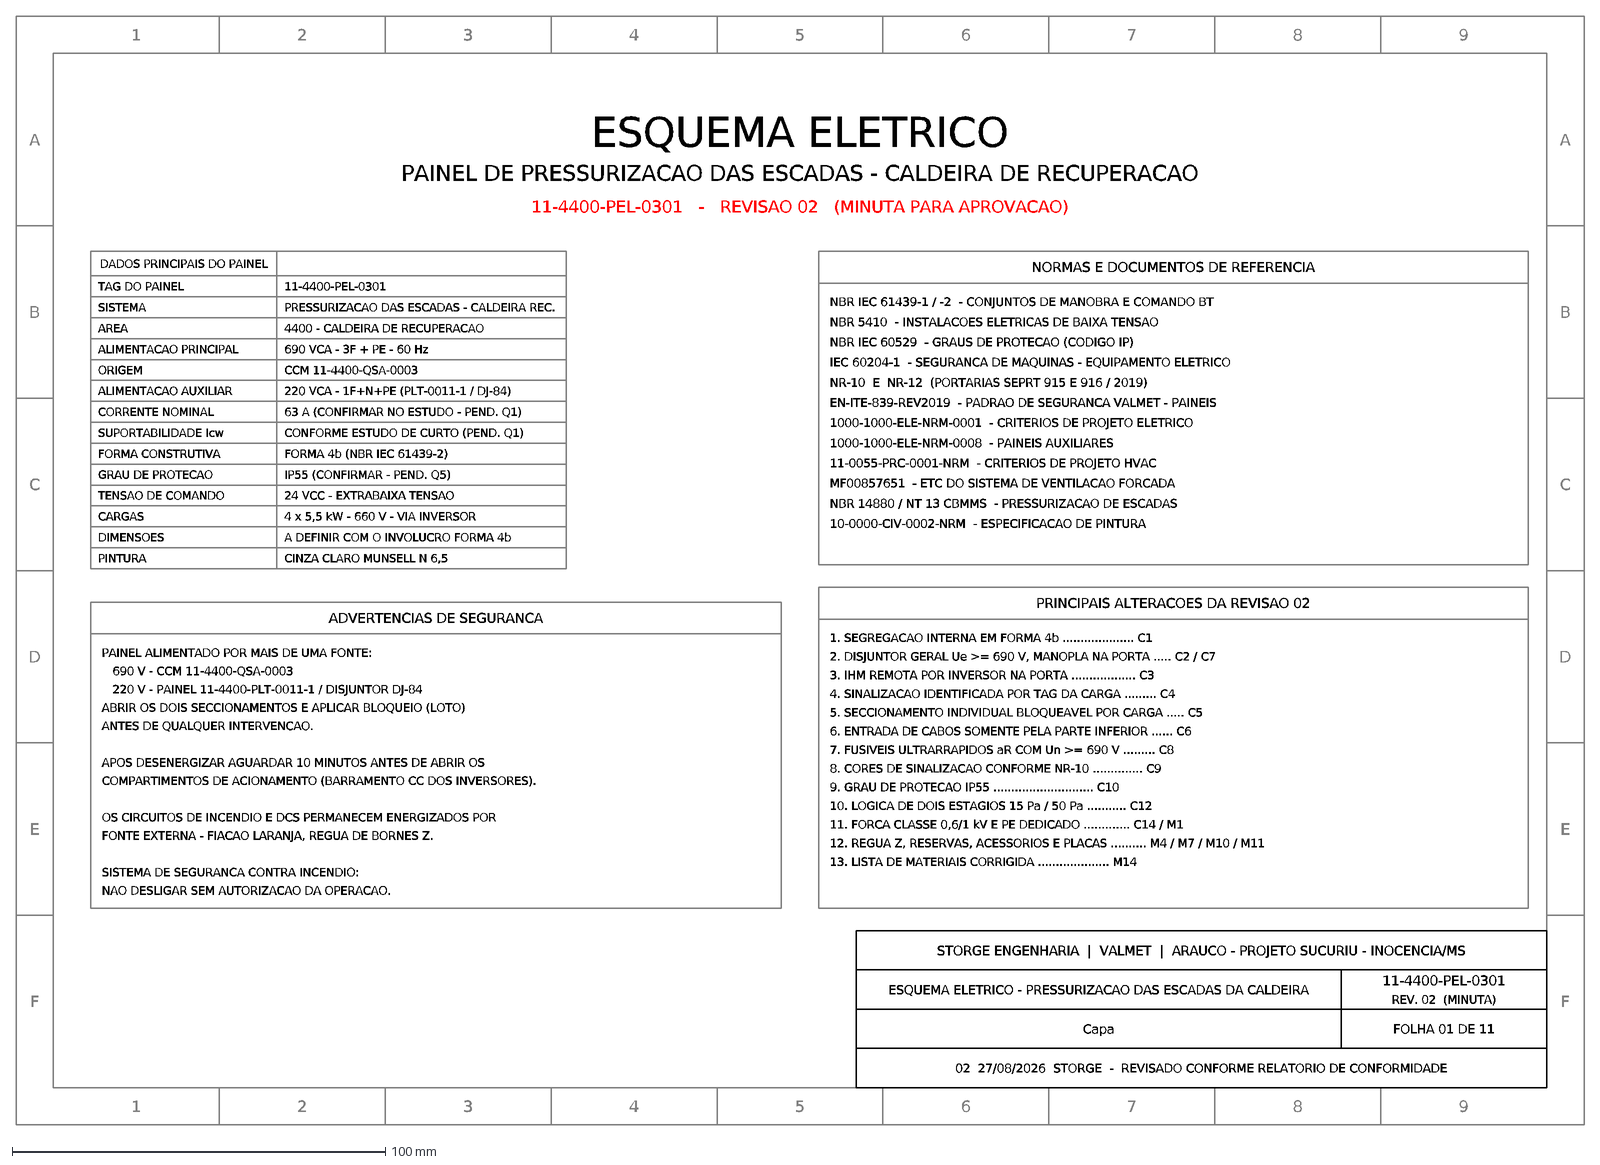
[picture p34: CAD file, 2026-08-29]
projeto/dxf/PEL-0301_01.dxf
1
2
3
4
5
6
7
8
9
F
E
D
C
B
A
STORGE ENGENHARIA | VALMET | ARAUCO - PROJETO SUCURIU - INOCENCIA/MS
ESQUEMA ELETRICO - PRESSURIZACAO DAS ESCADAS DA CALDEIRA
11-4400-PEL-0301
REV. 02 (MINUTA)
Capa
FOLHA 01 DE 11
02 27/08/2026 STORGE - REVISADO CONFORME RELATORIO DE CONFORMIDADE
ESQUEMA ELETRICO
PAINEL DE PRESSURIZACAO DAS ESCADAS - CALDEIRA DE RECUPERACAO
11-4400-PEL-0301 - REVISAO 02 (MINUTA PARA APROVACAO)
DADOS PRINCIPAIS DO PAINEL
TAG DO PAINEL
SISTEMA
PRESSURIZACAO DAS ESCADAS - CALDEIRA REC.
AREA
4400 - CALDEIRA DE RECUPERACAO
ALIMENTACAO PRINCIPAL
690 VCA - 3F + PE - 60 Hz
ORIGEM
CCM 11-4400-QSA-0003
ALIMENTACAO AUXILIAR
220 VCA - 1F+N+PE (PLT-0011-1 / DJ-84)
CORRENTE NOMINAL
63 A (CONFIRMAR NO ESTUDO - PEND. Q1)
SUPORTABILIDADE Icw
CONFORME ESTUDO DE CURTO (PEND. Q1)
FORMA CONSTRUTIVA
FORMA 4b (NBR IEC 61439-2)
GRAU DE PROTECAO
IP55 (CONFIRMAR - PEND. Q5)
TENSAO DE COMANDO
24 VCC - EXTRABAIXA TENSAO
CARGAS
4 x 5,5 kW - 660 V - VIA INVERSOR
DIMENSOES
A DEFINIR COM O INVOLUCRO FORMA 4b
PINTURA
CINZA CLARO MUNSELL N 6,5
NORMAS E DOCUMENTOS DE REFERENCIA
NBR IEC 61439-1 / -2 - CONJUNTOS DE MANOBRA E COMANDO BT
NBR 5410 - INSTALACOES ELETRICAS DE BAIXA TENSAO
NBR IEC 60529 - GRAUS DE PROTECAO (CODIGO IP)
IEC 60204-1 - SEGURANCA DE MAQUINAS - EQUIPAMENTO ELETRICO
NR-10 E NR-12 (PORTARIAS SEPRT 915 E 916 / 2019)
EN-ITE-839-REV2019 - PADRAO DE SEGURANCA VALMET - PAINEIS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
