JheanSilva/img-vent/projeto/dxf/PEL-0301_10.dxf

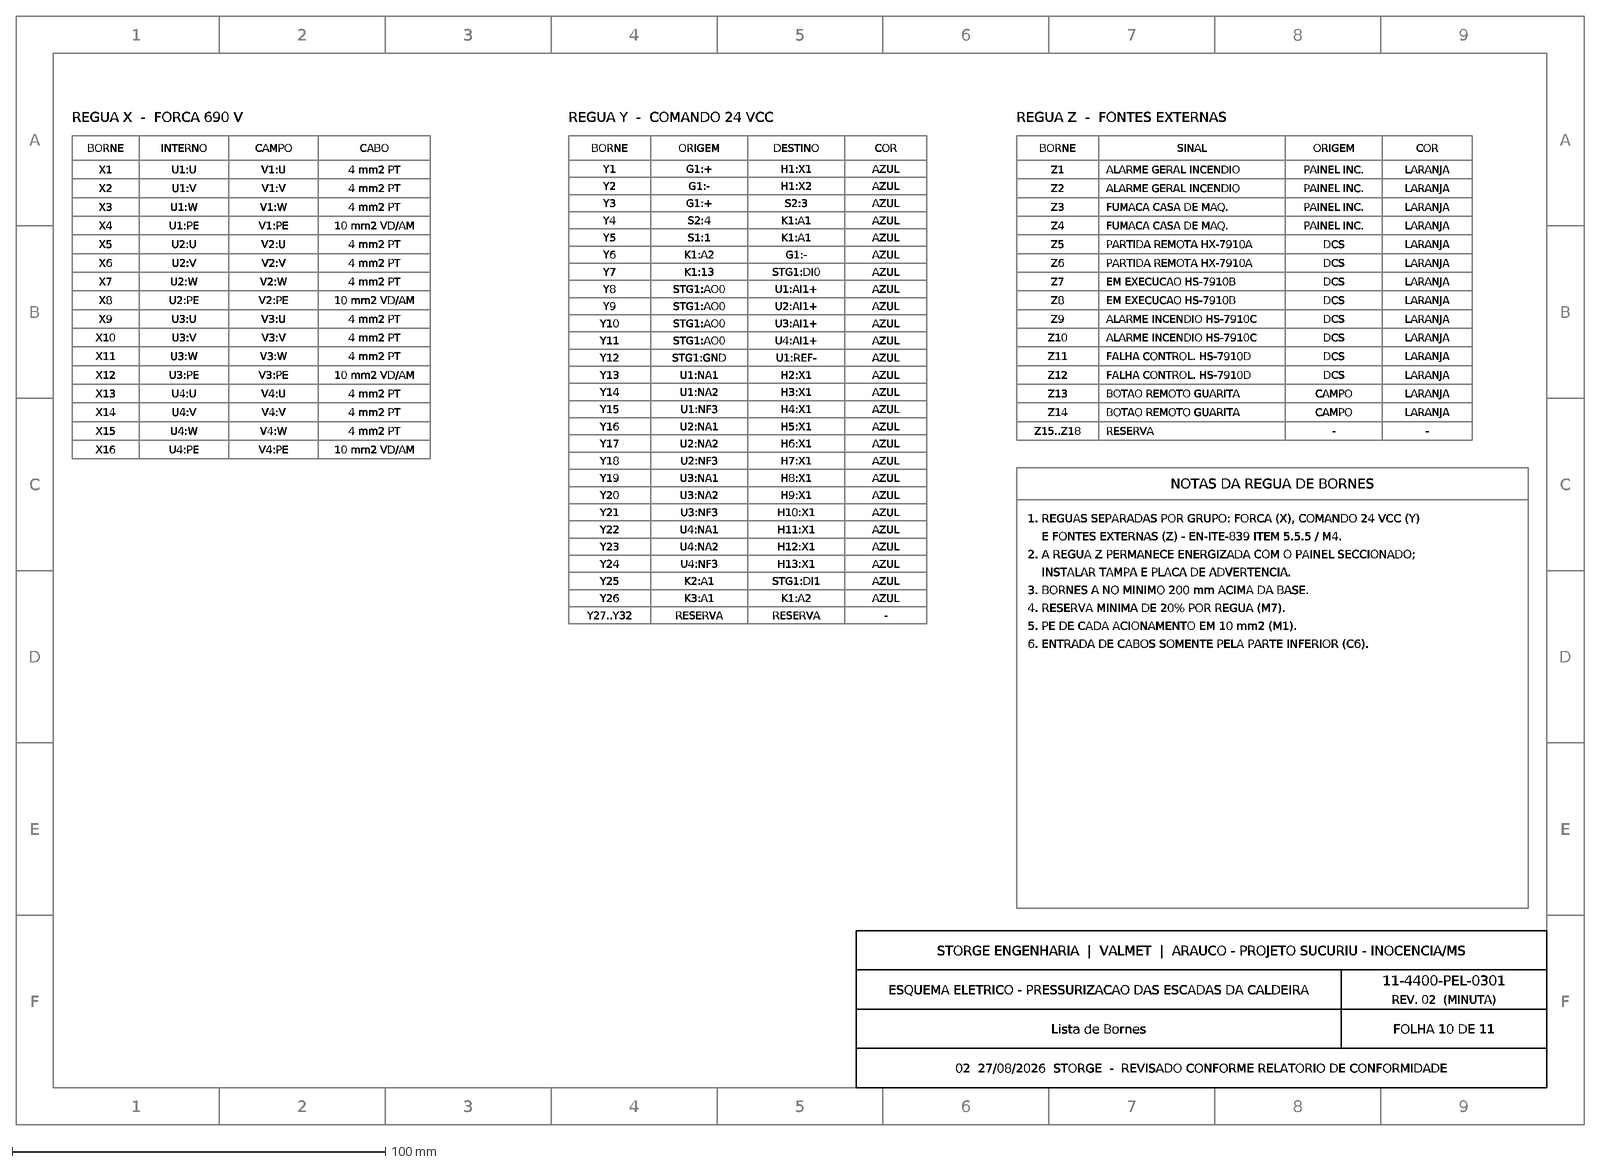
[picture p35: CAD file, 2026-08-29]
projeto/dxf/PEL-0301_10.dxf
1
2
3
4
5
6
7
8
9
F
E
D
C
B
A
STORGE ENGENHARIA | VALMET | ARAUCO - PROJETO SUCURIU - INOCENCIA/MS
ESQUEMA ELETRICO - PRESSURIZACAO DAS ESCADAS DA CALDEIRA
11-4400-PEL-0301
REV. 02 (MINUTA)
Lista de Bornes
FOLHA 10 DE 11
02 27/08/2026 STORGE - REVISADO CONFORME RELATORIO DE CONFORMIDADE
REGUA X - FORCA 690 V
BORNE
INTERNO
CAMPO
CABO
X1
U1:U
V1:U
4 mm2 PT
X2
U1:V
V1:V
X3
U1:W
V1:W
X4
U1:PE
V1:PE
10 mm2 VD/AM
X5
U2:U
V2:U
X6
U2:V
V2:V
X7
U2:W
V2:W
X8
U2:PE
V2:PE
X9
U3:U
V3:U
X10
U3:V
V3:V
X11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
