JheanSilva/img-vent/projeto/dxf/PEL-0301_04.dxf

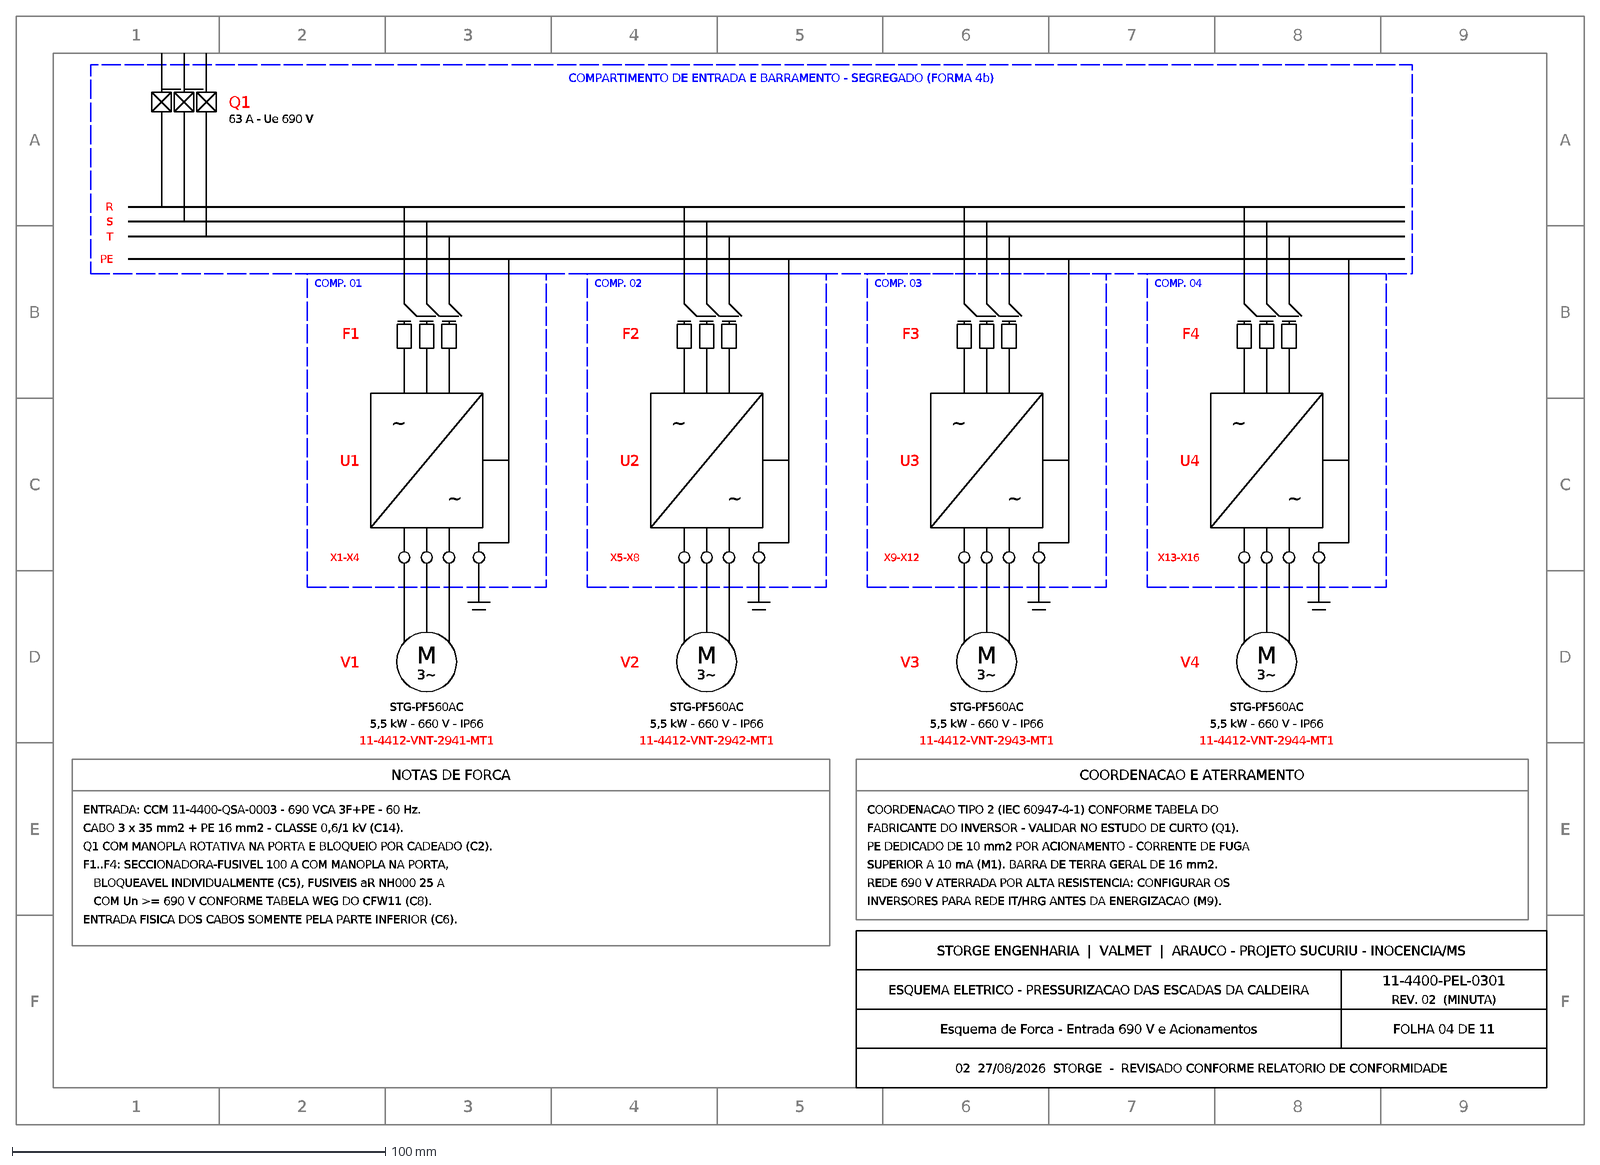
[picture p36: CAD file, 2026-08-29]
projeto/dxf/PEL-0301_04.dxf
1
2
3
4
5
6
7
8
9
F
E
D
C
B
A
STORGE ENGENHARIA | VALMET | ARAUCO - PROJETO SUCURIU - INOCENCIA/MS
ESQUEMA ELETRICO - PRESSURIZACAO DAS ESCADAS DA CALDEIRA
11-4400-PEL-0301
REV. 02 (MINUTA)
Esquema de Forca - Entrada 690 V e Acionamentos
FOLHA 04 DE 11
02 27/08/2026 STORGE - REVISADO CONFORME RELATORIO DE CONFORMIDADE
COMPARTIMENTO DE ENTRADA E BARRAMENTO - SEGREGADO (FORMA 4b)
Q1
63 A - Ue 690 V
R
S
T
PE
COMP. 01
F1
~
U1
X1-X4
M
3~
V1
STG-PF560AC
5,5 kW - 660 V - IP66
11-4412-VNT-2941-MT1
COMP. 02
F2
U2
X5-X8
V2
11-4412-VNT-2942-MT1
COMP. 03
F3
U3
X9-X12
V3
11-4412-VNT-2943-MT1
COMP. 04
F4
U4
X13-X16
V4
11-4412-VNT-2944-MT1
NOTAS DE FORCA
ENTRADA: CCM 11-4400-QSA-0003 - 690 VCA 3F+PE - 60 Hz.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
