JheanSilva/img-vent/projeto/dxf/PEL-0301_11.dxf

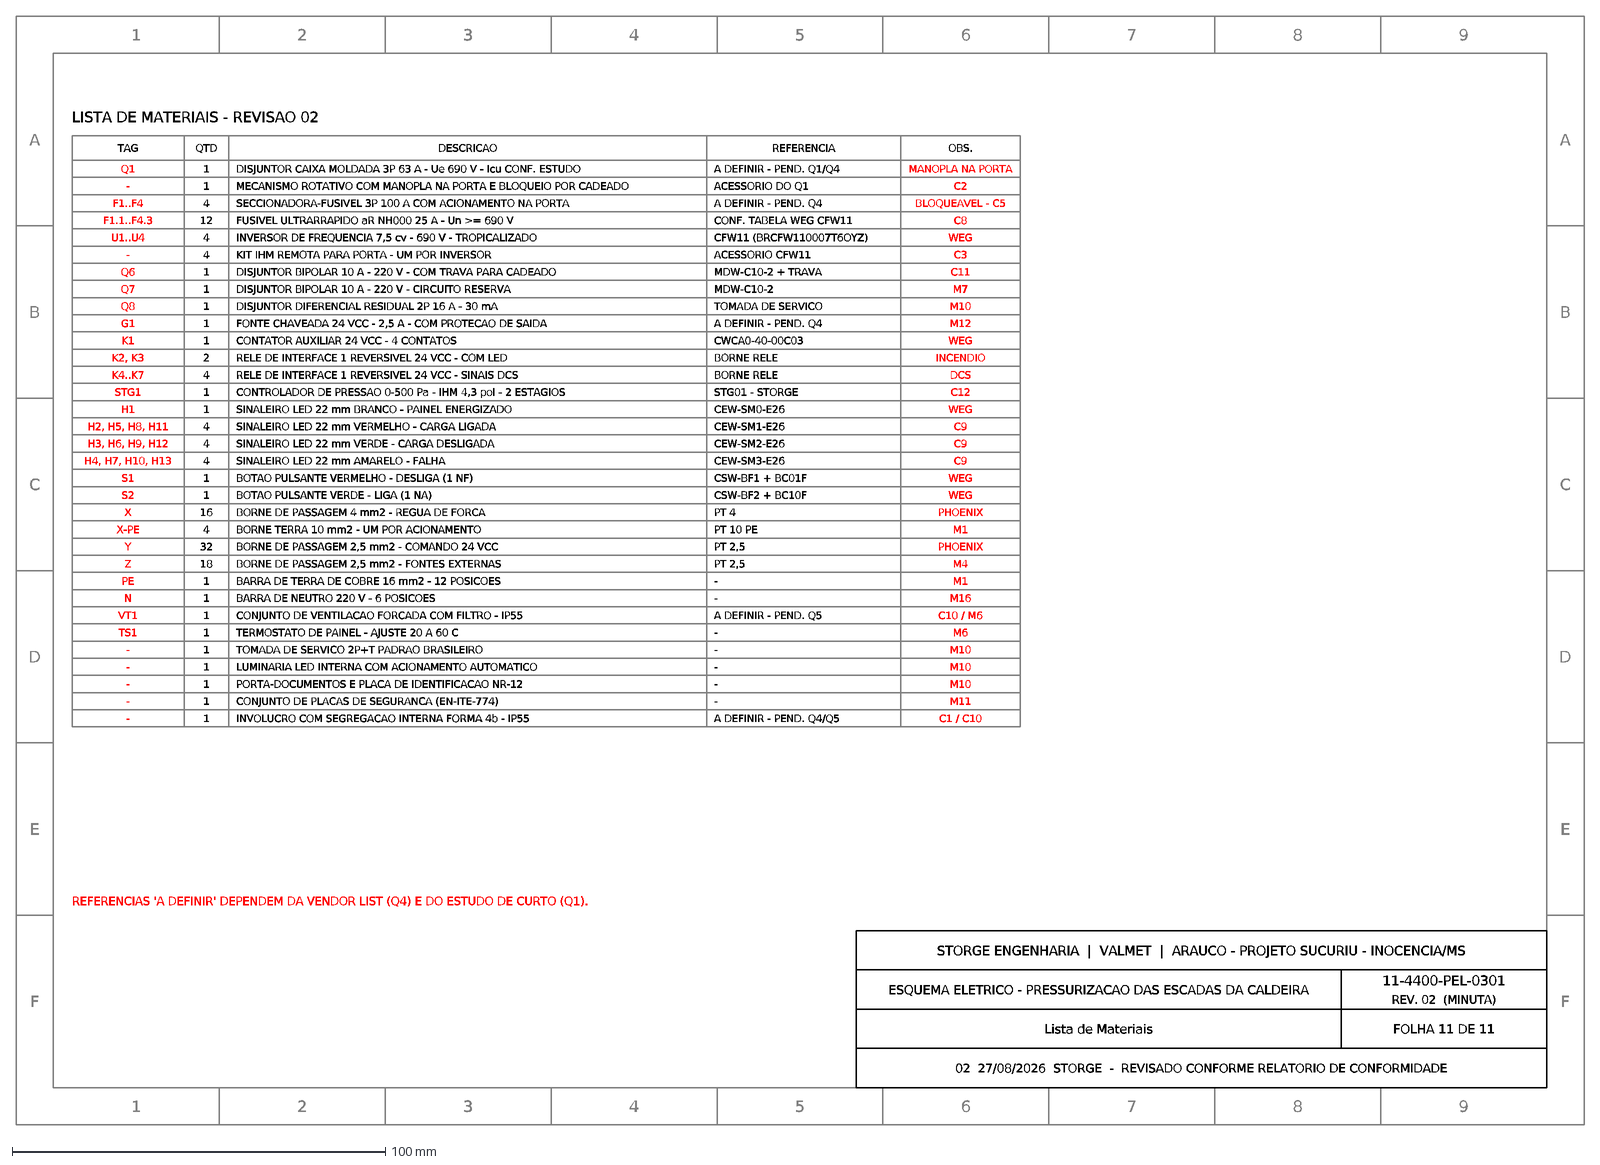
[picture p37: CAD file, 2026-08-29]
projeto/dxf/PEL-0301_11.dxf
1
2
3
4
5
6
7
8
9
F
E
D
C
B
A
STORGE ENGENHARIA | VALMET | ARAUCO - PROJETO SUCURIU - INOCENCIA/MS
ESQUEMA ELETRICO - PRESSURIZACAO DAS ESCADAS DA CALDEIRA
11-4400-PEL-0301
REV. 02 (MINUTA)
Lista de Materiais
FOLHA 11 DE 11
02 27/08/2026 STORGE - REVISADO CONFORME RELATORIO DE CONFORMIDADE
LISTA DE MATERIAIS - REVISAO 02
TAG
QTD
DESCRICAO
REFERENCIA
OBS.
Q1
DISJUNTOR CAIXA MOLDADA 3P 63 A - Ue 690 V - Icu CONF. ESTUDO
A DEFINIR - PEND. Q1/Q4
MANOPLA NA PORTA
-
MECANISMO ROTATIVO COM MANOPLA NA PORTA E BLOQUEIO POR CADEADO
ACESSORIO DO Q1
C2
F1..F4
SECCIONADORA-FUSIVEL 3P 100 A COM ACIONAMENTO NA PORTA
A DEFINIR - PEND. Q4
BLOQUEAVEL - C5
F1.1..F4.3
12
FUSIVEL ULTRARRAPIDO aR NH000 25 A - Un >= 690 V
CONF. TABELA WEG CFW11
C8
U1..U4
INVERSOR DE FREQUENCIA 7,5 cv - 690 V - TROPICALIZADO
CFW11 (BRCFW110007T6OYZ)
WEG
KIT IHM REMOTA PARA PORTA - UM POR INVERSOR
ACESSORIO CFW11
C3
Q6
DISJUNTOR BIPOLAR 10 A - 220 V - COM TRAVA PARA CADEADO
MDW-C10-2 + TRAVA
C11
Q7
DISJUNTOR BIPOLAR 10 A - 220 V - CIRCUITO RESERVA
MDW-C10-2
M7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
