JheanSilva/img-vent/projeto/dxf/PEL-0301_07.dxf

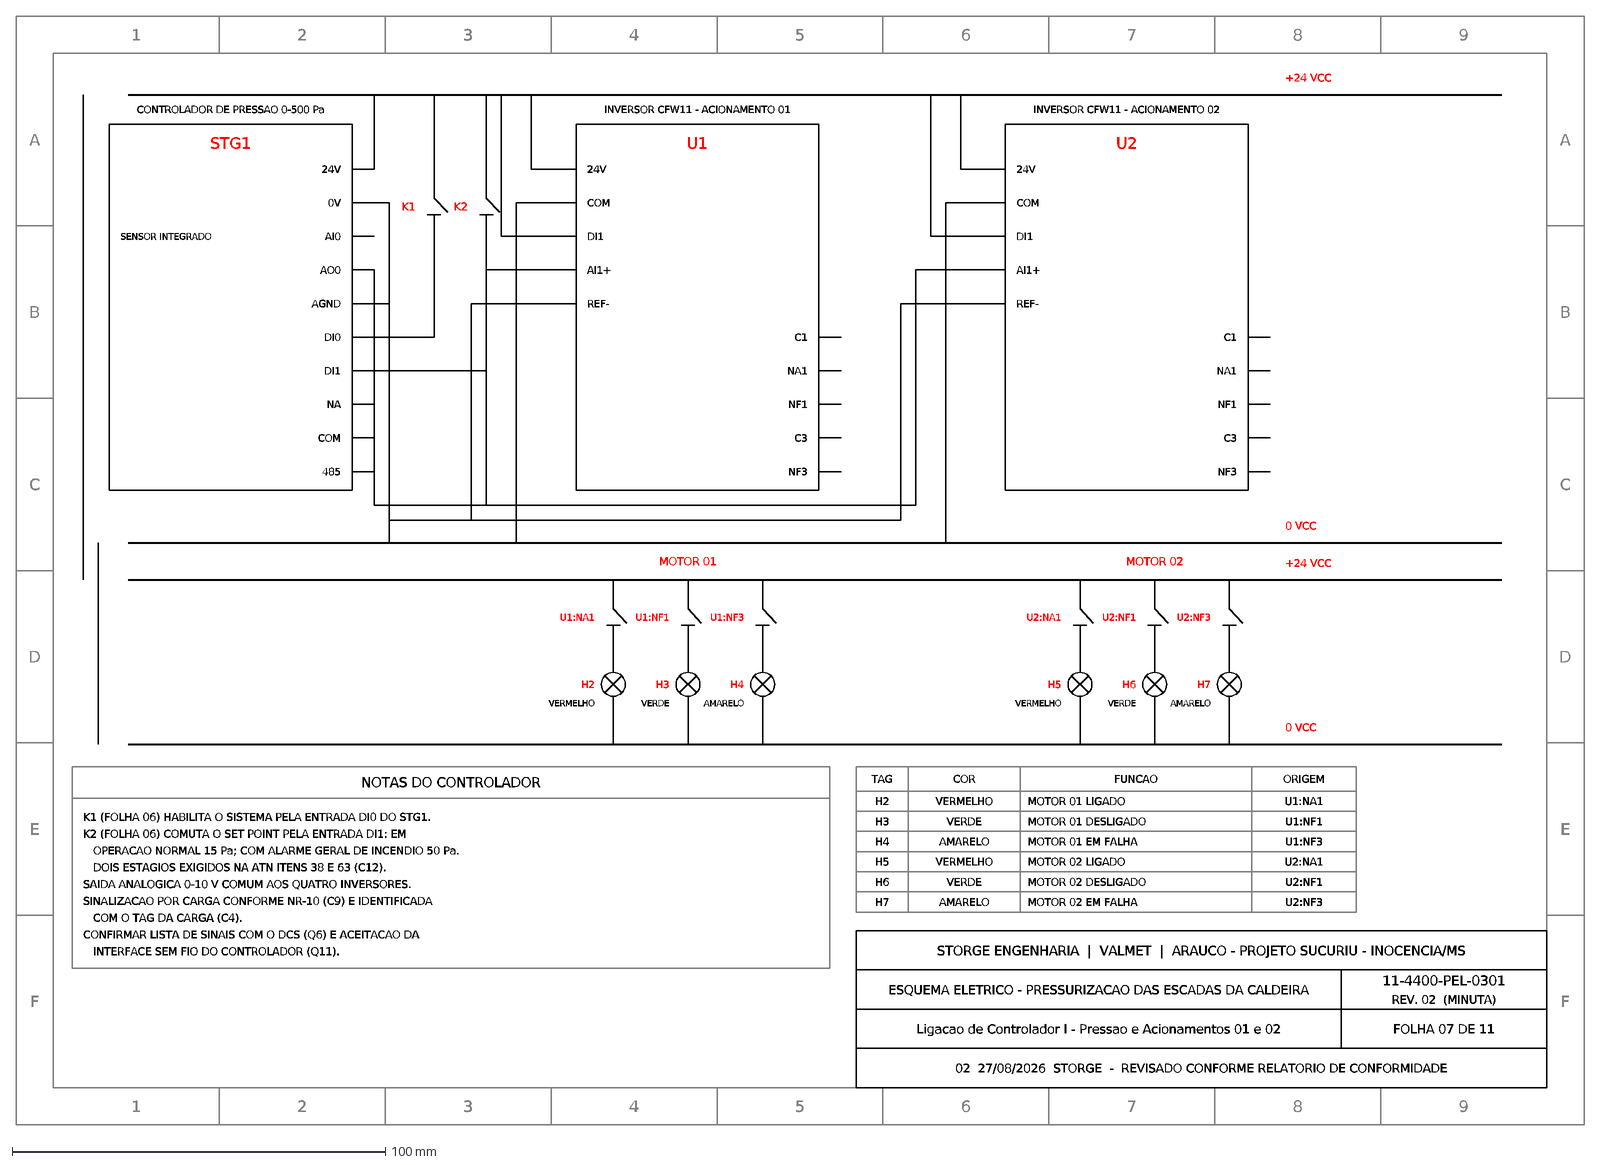
[picture p38: CAD file, 2026-08-29]
projeto/dxf/PEL-0301_07.dxf
1
2
3
4
5
6
7
8
9
F
E
D
C
B
A
STORGE ENGENHARIA | VALMET | ARAUCO - PROJETO SUCURIU - INOCENCIA/MS
ESQUEMA ELETRICO - PRESSURIZACAO DAS ESCADAS DA CALDEIRA
11-4400-PEL-0301
REV. 02 (MINUTA)
Ligacao de Controlador I - Pressao e Acionamentos 01 e 02
FOLHA 07 DE 11
02 27/08/2026 STORGE - REVISADO CONFORME RELATORIO DE CONFORMIDADE
+24 VCC
0 VCC
STG1
CONTROLADOR DE PRESSAO 0-500 Pa
24V
0V
AI0
AO0
AGND
DI0
DI1
NA
COM
485
SENSOR INTEGRADO
U1
INVERSOR CFW11 - ACIONAMENTO 01
AI1+
REF-
C1
NA1
NF1
C3
NF3
U2
INVERSOR CFW11 - ACIONAMENTO 02
K1
K2
MOTOR 01
U1:NA1
H2
VERMELHO
U1:NF1
H3
VERDE
U1:NF3
H4
AMARELO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
