JheanSilva/img-vent/projeto/LAYOUT_PAINEL.pdf

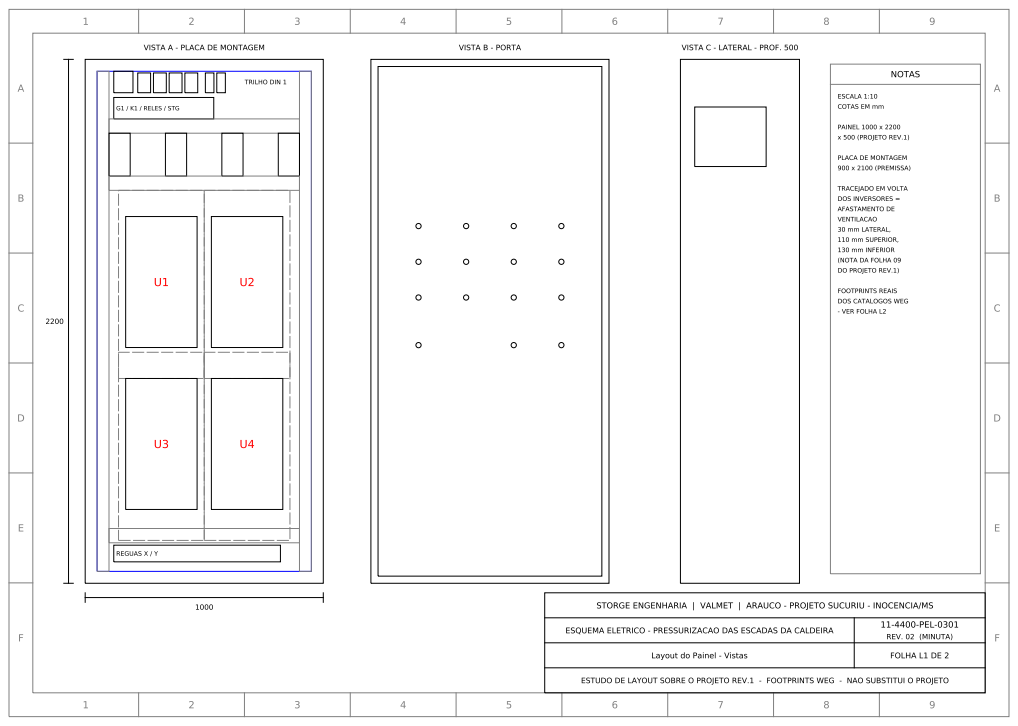
[picture p39: page 1]

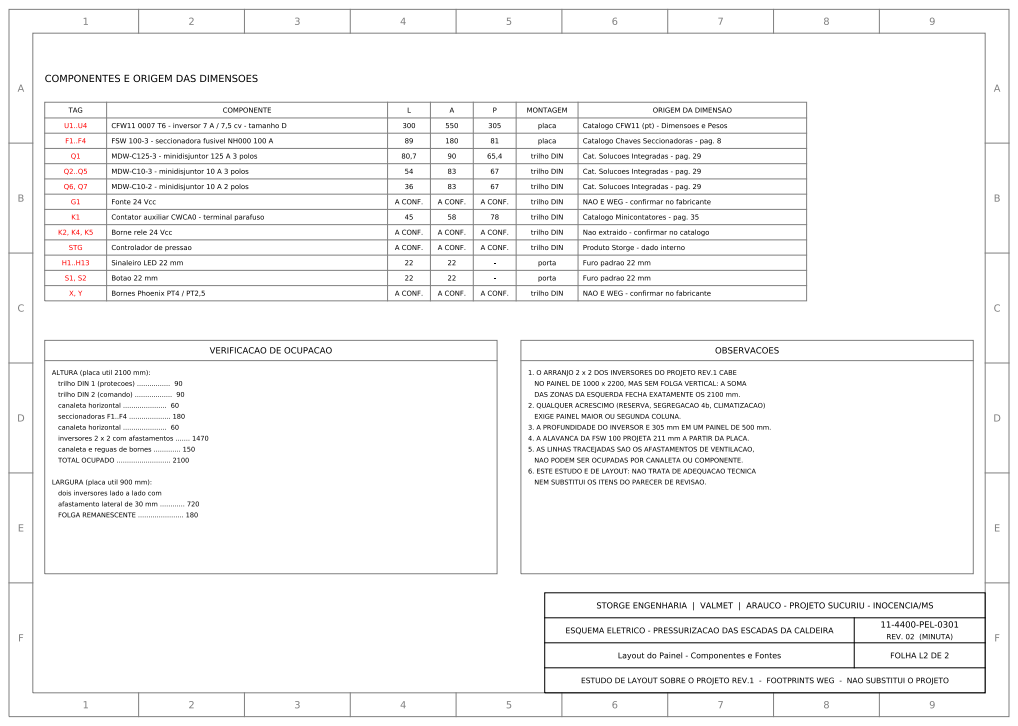
[picture p40: page 2]
