JheanSilva/img-vent/projeto/dxf_layout/LAYOUT_PAINEL.pdf

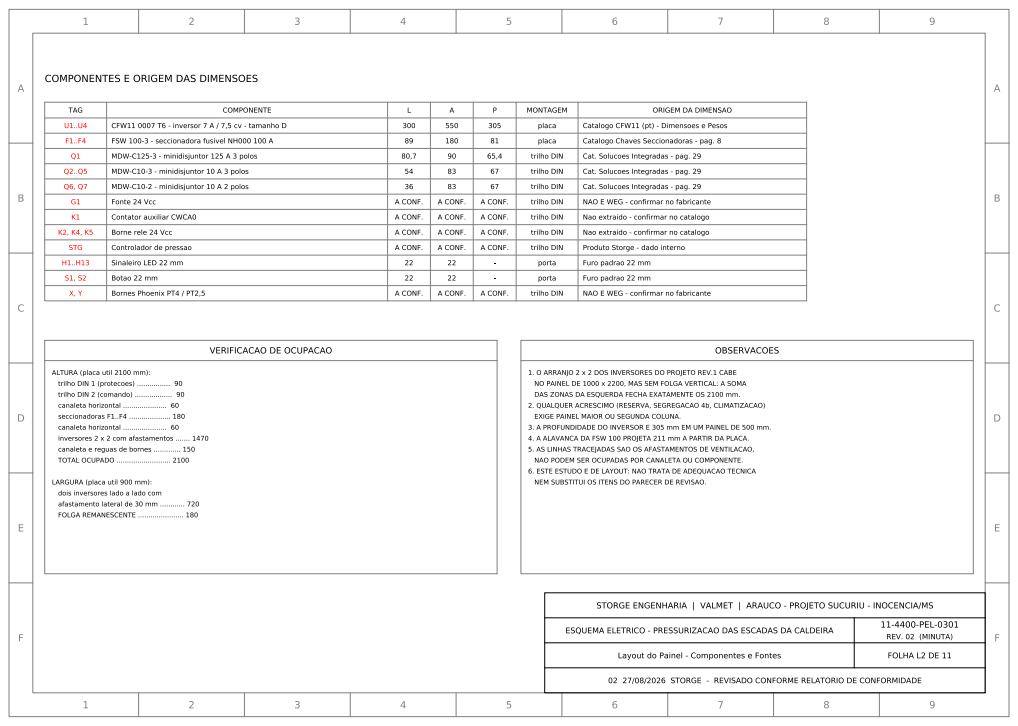
[picture p52: page 1]
