JheanSilva/img-vent/(commit log)

2026-08-27 Adiciona relatório de conformidade do painel de pressurização (MF00965787 rev.1)
    Análise requisito a requisito do projeto 11-4400-PEL-0301 contra as
    especificações do cliente (EN-ITE-839, ETC MF00857651, ATN, normas
    Arauco ELE/AUT/PRC/INC e padrões de documentação): 14 não conformidades
    críticas, itens médios de projeto/documentação, itens conformes e 12
    pendências que dependem de informação externa.
    Claude-Session: https://claude.ai/code/session_017Am9H5WMYSCKKhriwcenkd
2026-08-28 Adiciona leitura por escopo e fase: sistema × quadro, projeto × fabricação
    Nova seção 4-A classifica cada achado do relatório em dois cortes:
    (1) o que pertence ao projeto do sistema de pressurização e o que é do
    quadro elétrico PEL-0301; (2) dentro do quadro, o que precisa constar
    na rev.2 do projeto e o que é conformidade a executar e evidenciar na
    fabricação (compras, execução, configuração, ensaios).
    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
2026-08-28 Adiciona gerador da folha-piloto do unifilar (DXF) com validador de layout
    Script que produz a folha A3 do unifilar 11-4400-PEL-0301 (conceito rev.2)
    em DXF/PDF/PNG. O layout usa zonas reservadas por coluna e mede a largura
    dos textos pela metrica real da fonte (ezdxf.fonts), em vez de estimativa;
    um validador acusa sobreposicao texto/texto, texto/geometria e estouro de
    zona, e a exportacao so ocorre com zero ocorrencias.
    Inclui o DXF gerado da folha-piloto.
    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
    [PEL-0301_unifilar_piloto.dxf]
2026-08-29 Gera a revisao 02 completa do 11-4400-PEL-0301 (11 folhas, minuta)
    Caderno completo em DXF/PDF produzido pelo motor de layout validado
    (folha.py): zonas reservadas por coluna, largura de texto medida pela
    metrica real da fonte e validador que bloqueia a exportacao enquanto
    houver sobreposicao texto/texto, texto/geometria ou estouro de zona.
    As 11 folhas passam com zero ocorrencias.
    Correcoes do relatorio de conformidade incorporadas:
    - C1 segregacao interna Forma 4b (folhas 04 e 09)
    - C2/C7 disjuntor geral em caixa moldada Ue >= 690 V com manopla na porta
    - C3 IHM remota por inversor na porta
    - C4 sinalizacao identificada por tag da carga
    - C5 seccionamento individual bloqueavel por acionam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
    [PEL-0301_01.dxf, PEL-0301_02.dxf, PEL-0301_03.dxf, PEL-0301_04.dxf, PEL-0301_05.dxf, PEL-0301_06.dxf, PEL-0301_07.dxf, PEL-0301_08.dxf]
2026-08-31 Adiciona parecer tecnico de revisao carimbado sobre o MF00965787 rev.1
    Caderno de 24 paginas: capa com resumo por folha, mapa dos comentarios
    do cliente e pendencias a consultar; as 11 folhas originais com as notas
    carimbadas; uma pagina de detalhamento apos cada folha (onde, acao, por
    que com a norma que obriga, e como fazer); e checklist final para
    acompanhamento da revisao.
    68 notas: 25 criticas, 30 importantes, 10 informativas e 3 pendencias.
    O carimbo e posicionado automaticamente na area livre de cada folha,
    detectada por analise de cobertura de tinta da pagina rasterizada.
    Claude-Session: https://claude.ai/code/session_017Am9H5WM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
2026-09-03 Adiciona estudo de layout do painel com footprints reais dos catalogos WEG
    Duas folhas A3 (DXF + PDF) montadas sobre o painel 1000 x 2200 x 500 do
    projeto rev.1: vista da placa de montagem, vista da porta e vista lateral
    em 1:10, mais a tabela de componentes com a origem de cada dimensao.
    Dimensoes extraidas dos catalogos publicos da WEG (static.weg.net):
    - CFW11 0007 T6 = tamanho D: 300 x 550 x 305 mm (Dimensoes e Pesos)
    - FSW 100-3: 89 x 180 x 81 mm, 211 mm com alavanca (Chaves Seccionadoras p.8)
    - MDW 125 A 3P: 80,7 mm / MDWP-MDWS 3P: 54 mm / 2P: 36 mm (Solucoes p.29)
    O portal ecatalog.weg.net esta bloqueado por CDN neste ambiente; as
    dimensoes vieram dos catalogos em PDF do proprio dom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
    [LAYOUT_L1.dxf, LAYOUT_L2.dxf]
2026-09-03 Acrescenta dimensoes do contator CWCA0 ao estudo de layout
    CWCA0 terminal parafuso: 45 x 58 x 78 mm, do catalogo de minicontatores
    da WEG (pag. 35), obtido pelo mesmo caminho dos demais componentes.
    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
    [LAYOUT_L1.dxf, LAYOUT_L2.dxf]
